jalmx/Smart-Switch/README.md

# Smart-Switch

Sistema inteligente para control de encendido de luces en interiores por medio de un switch touch o con un sensor PIR. Desarrollado con un PIC12F508

Información detalla del desarrollo esta en [documentación](documentacion/Smart_Switch.pdf)

# Vistas

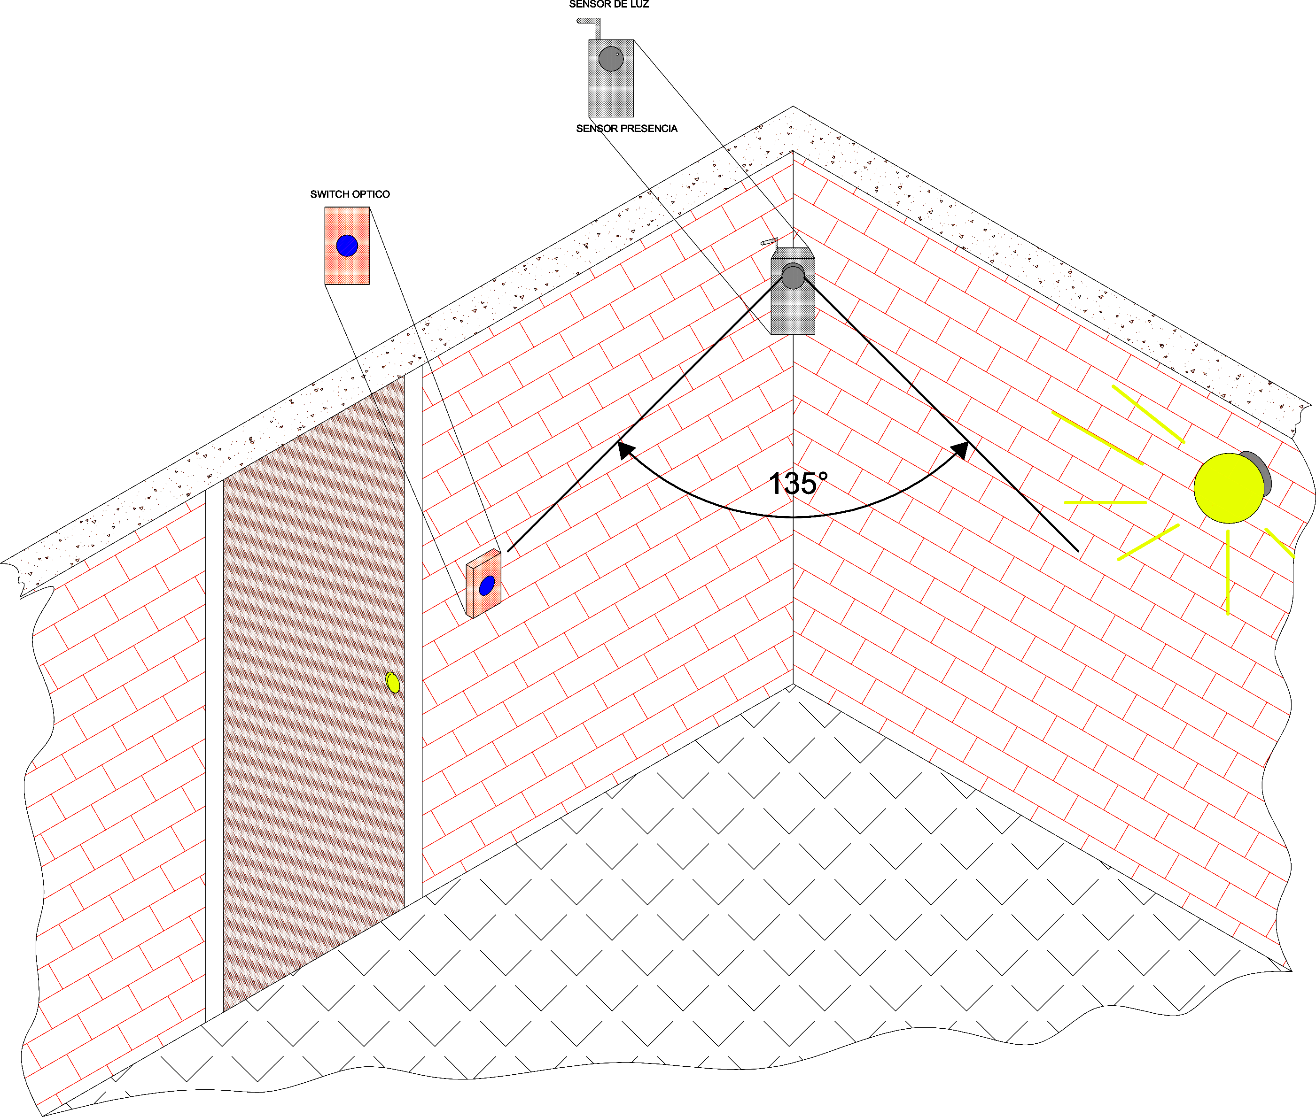
[picture p1: Gabinete y Pictorico/pictorico.png]
Pictorico
* 
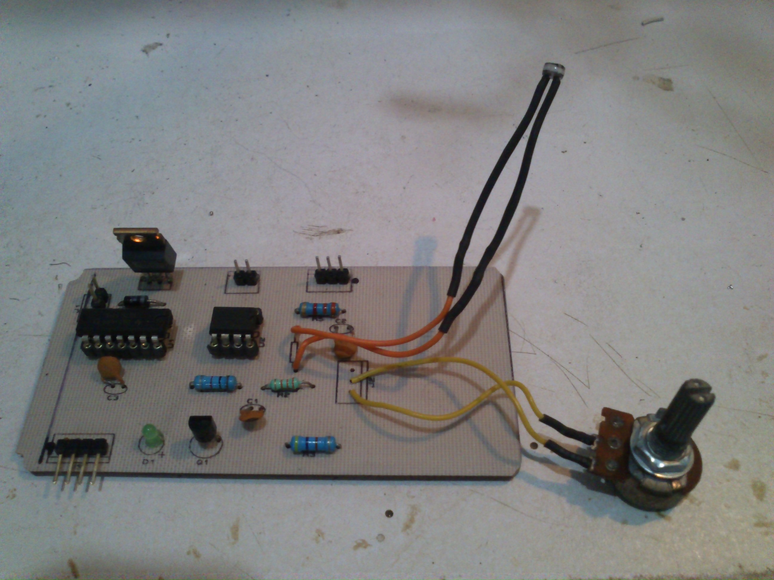
[picture p2: Fotos/2014-06-17 13.12.39.jpg]
Ultima vista
* 

## Esquematico

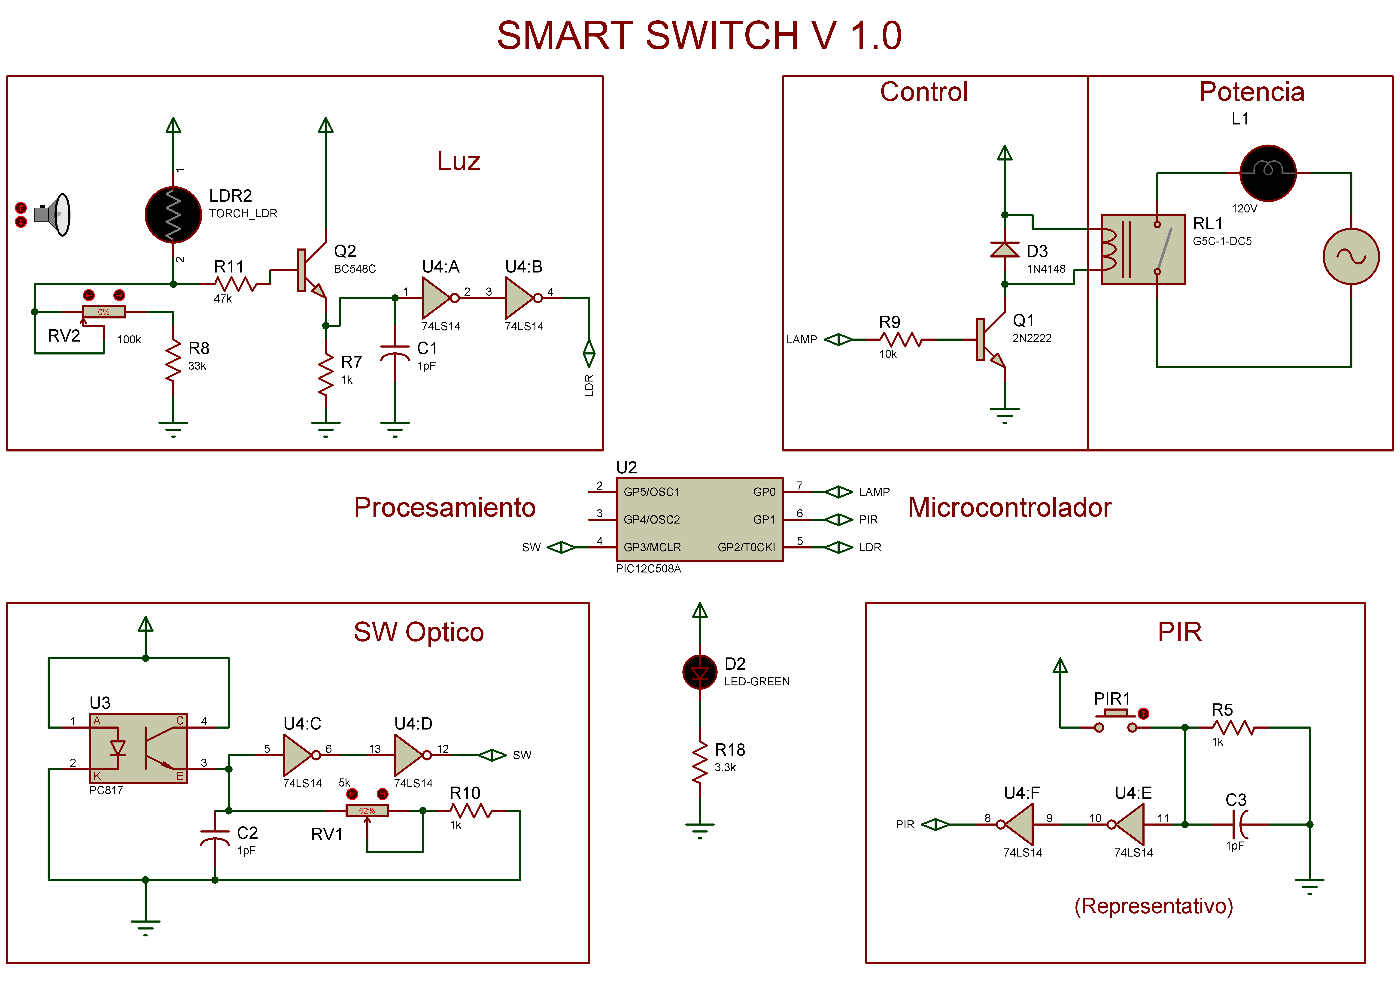
[picture p3: General/SW-SMART.png]
esquematico


# IDE de desarrollo:

* [Microchip X IDE](http://www.microchip.com/mplab/mplab-x-ide#) 

mplab x

* [Proteus](https://www.labcenter.com/)

proteus
