jalmx/Smart-Switch/PCB/SUB_PCB/SUB -3D Visualizer.pdf

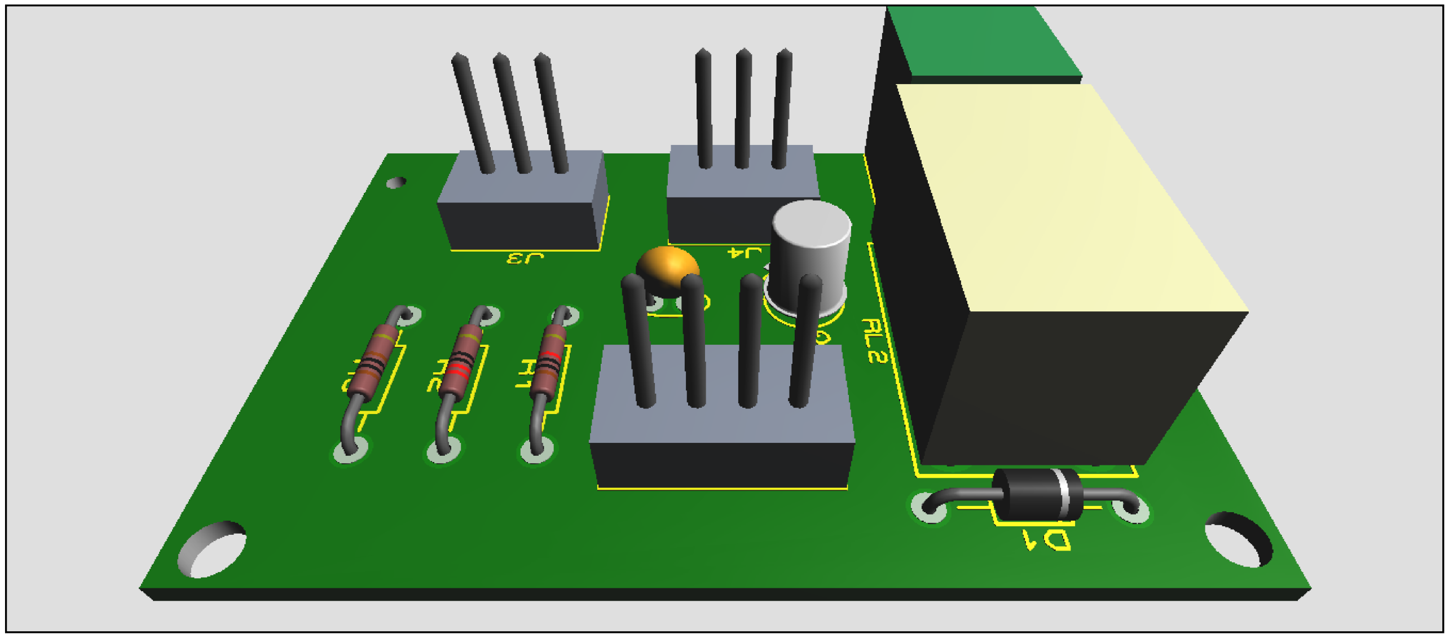
[picture p42: figure]
