jalmx/Smart-Switch/PCB/SW_OP_PCB/sw_op - Proteus 8 Professional - 3D Visualizer.pdf

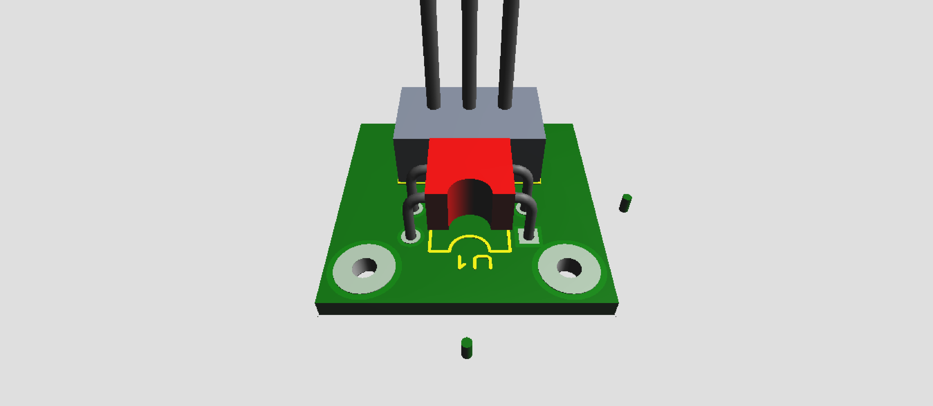
[picture p43: figure]
