jalmx/Smart-Switch/Fotos/2014-03-11 21.48.35.jpg

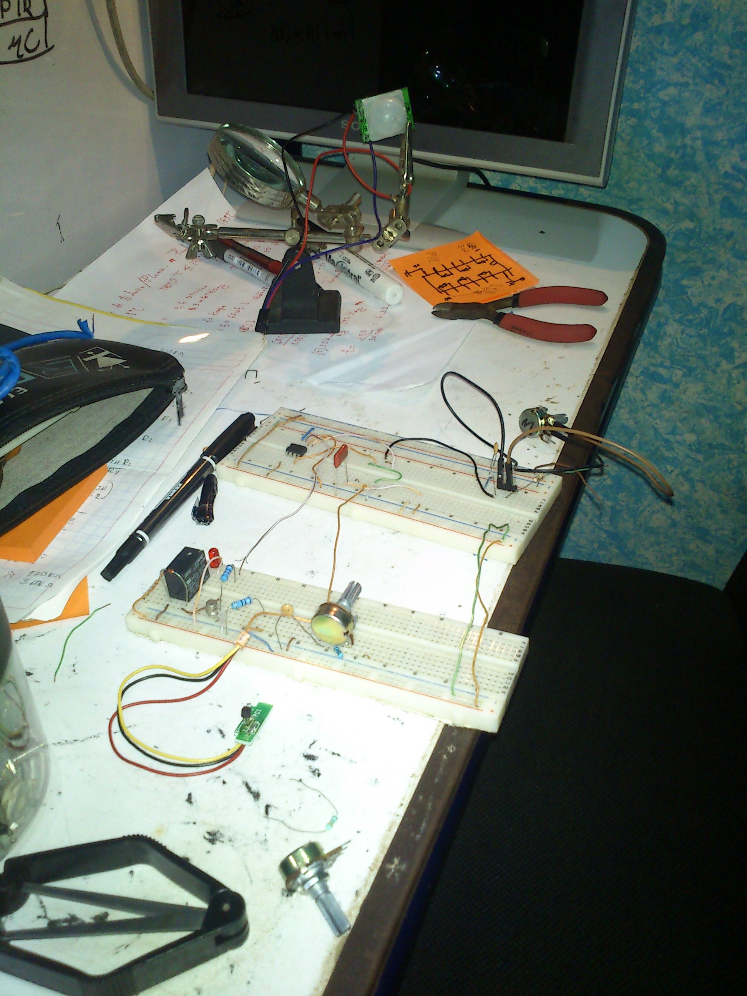
Fotos/2014-03-11 21.48.35.jpg
