jalmx/Smart-Switch/Fotos/2014-03-12 23.23.10.jpg

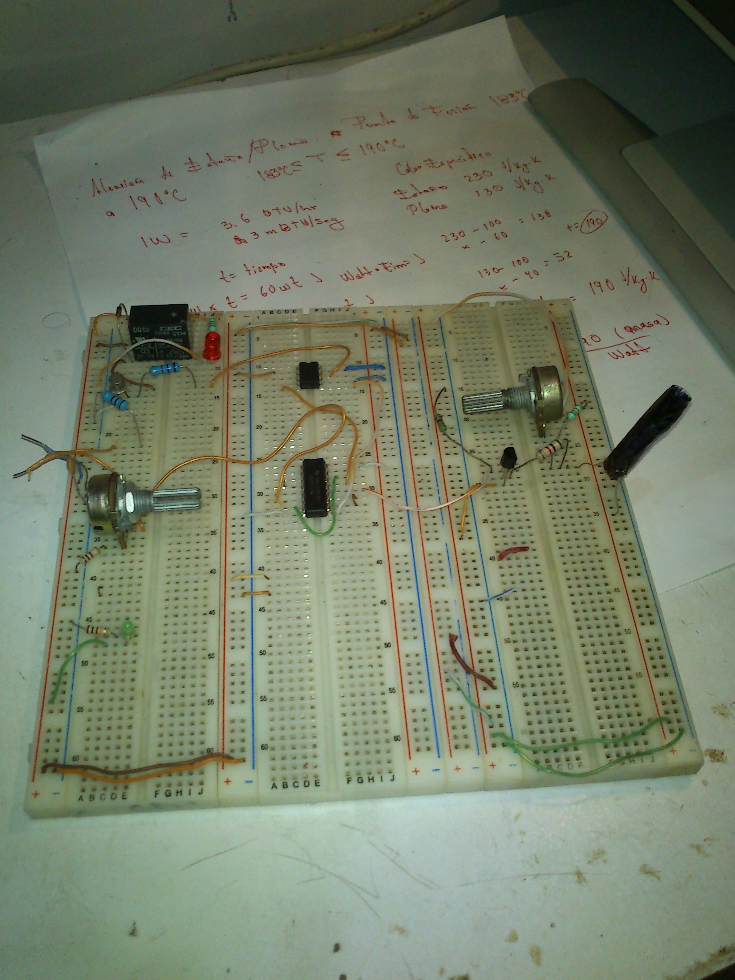
Fotos/2014-03-12 23.23.10.jpg
