jalmx/Smart-Switch/Fotos/2014-03-12 23.23.17.jpg

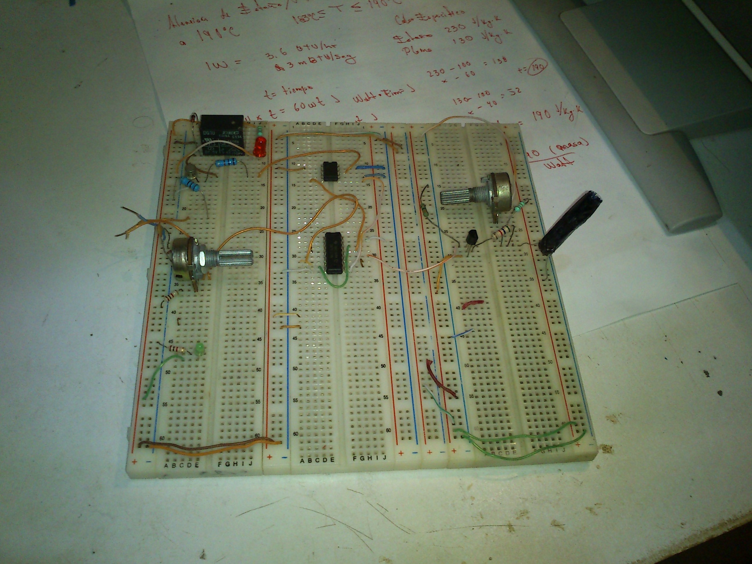
Fotos/2014-03-12 23.23.17.jpg
