jalmx/Smart-Switch/Fotos/2014-03-13 12.28.27.jpg

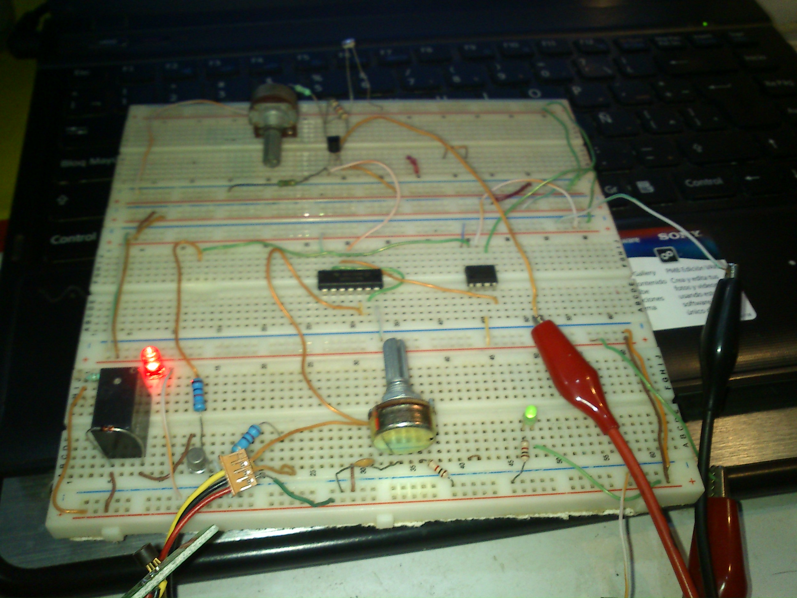
Fotos/2014-03-13 12.28.27.jpg
