jalmx/Smart-Switch/Fotos/2014-03-15 14.15.27.jpg

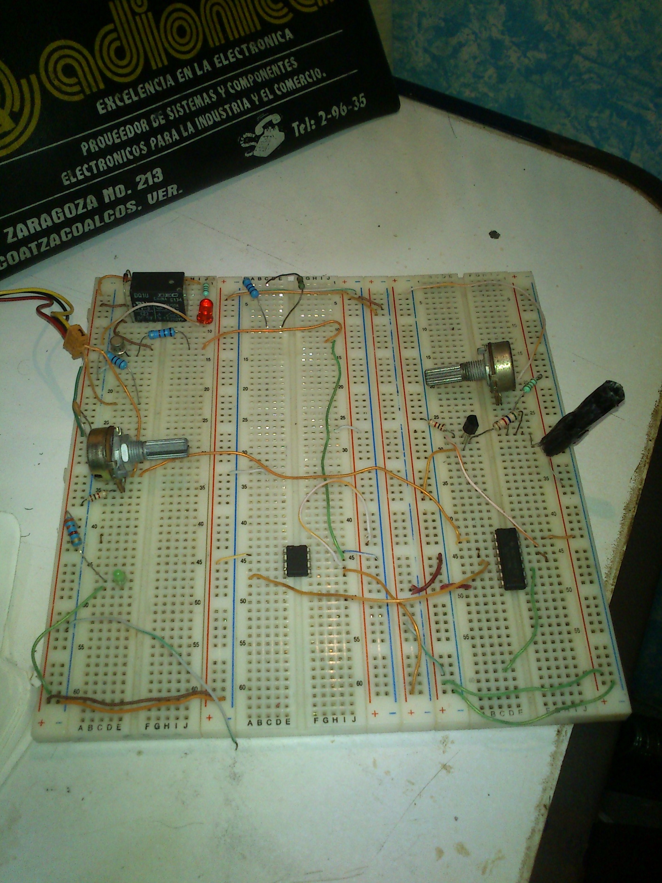
Fotos/2014-03-15 14.15.27.jpg
