jalmx/Smart-Switch/Fotos/2014-05-26 22.24.50.jpg

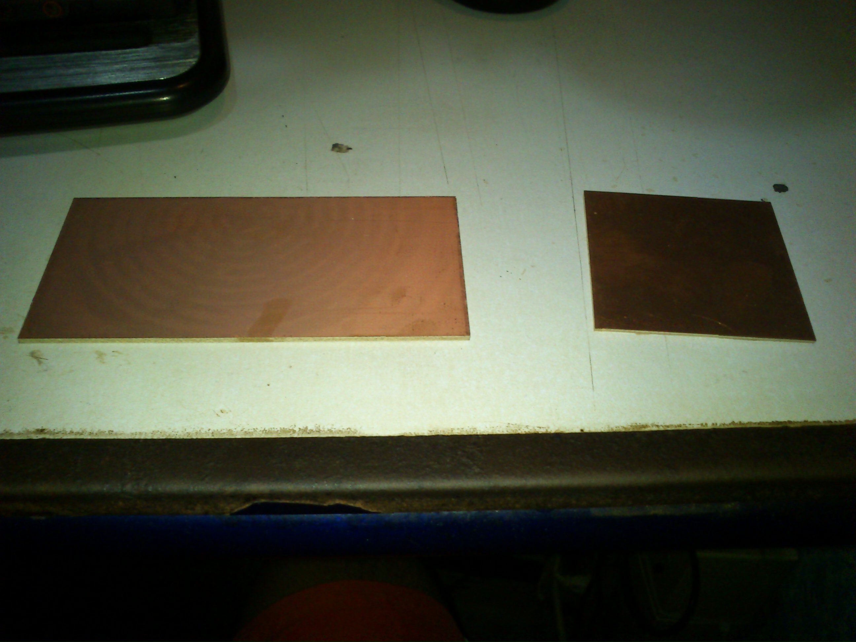
Fotos/2014-05-26 22.24.50.jpg
