jalmx/Smart-Switch/Fotos/2014-05-27 14.17.57.jpg

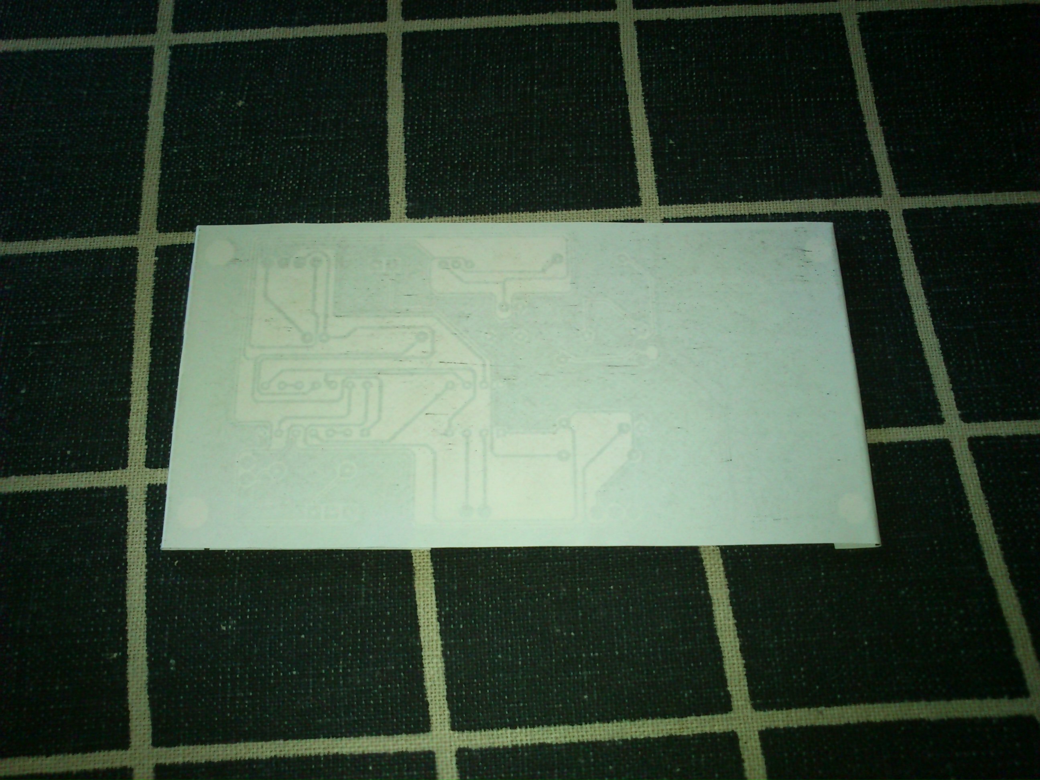
Fotos/2014-05-27 14.17.57.jpg
