jalmx/Smart-Switch/Fotos/2014-05-27 14.18.19.jpg

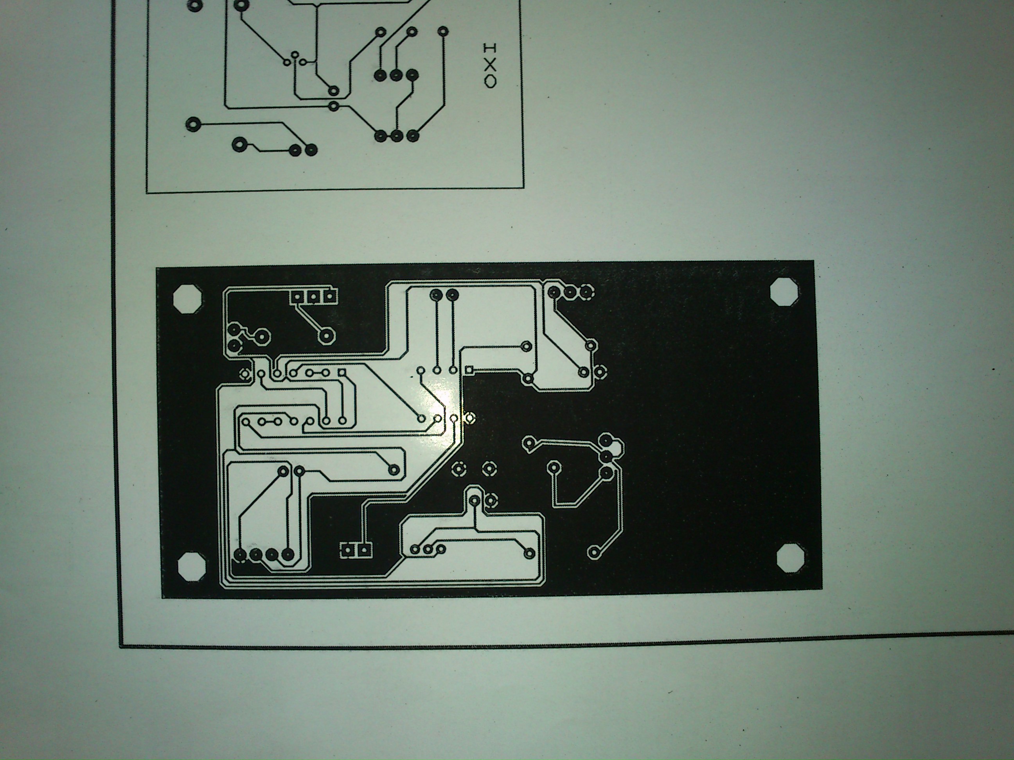
Fotos/2014-05-27 14.18.19.jpg
