jalmx/Smart-Switch/Fotos/2014-05-27 14.36.23.jpg

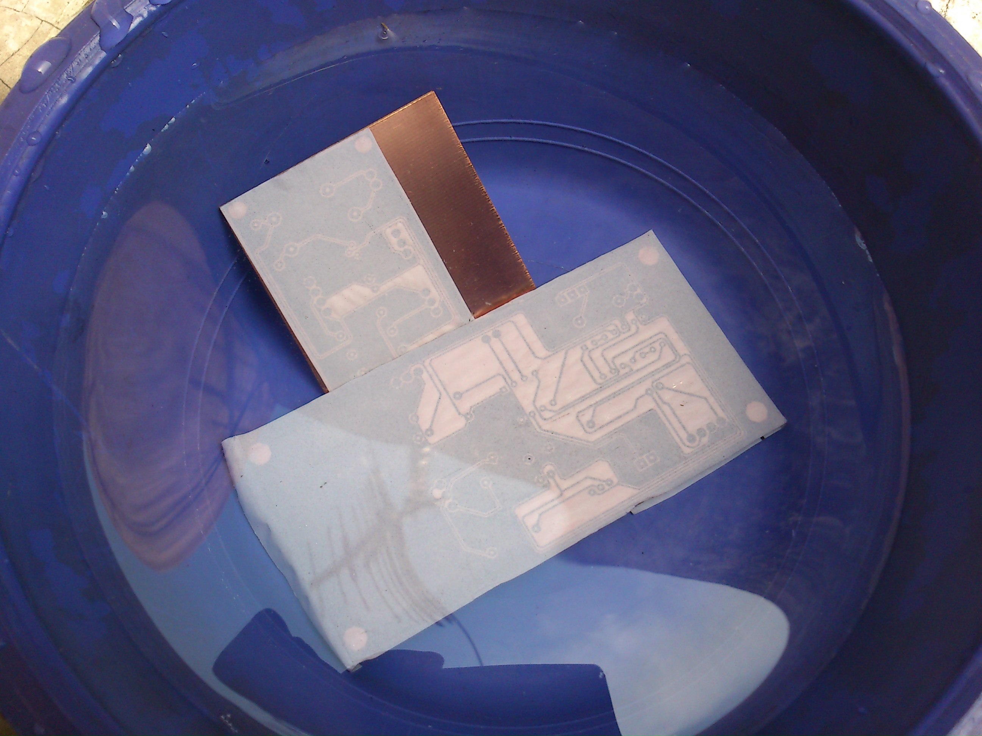
Fotos/2014-05-27 14.36.23.jpg
