jalmx/Smart-Switch/Fotos/2014-06-09 14.02.02.jpg

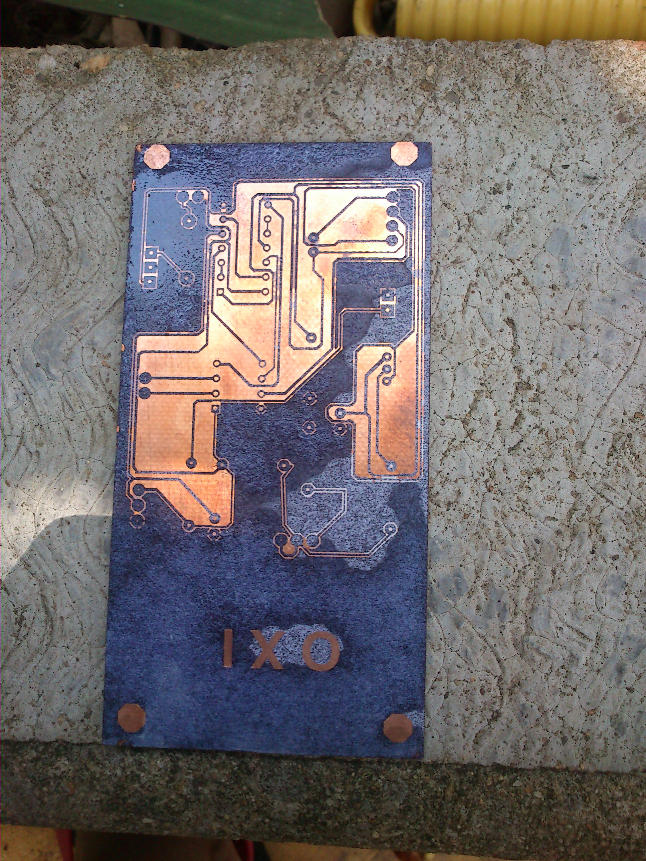
Fotos/2014-06-09 14.02.02.jpg
