jalmx/Smart-Switch/Fotos/2014-06-09 14.02.08.jpg

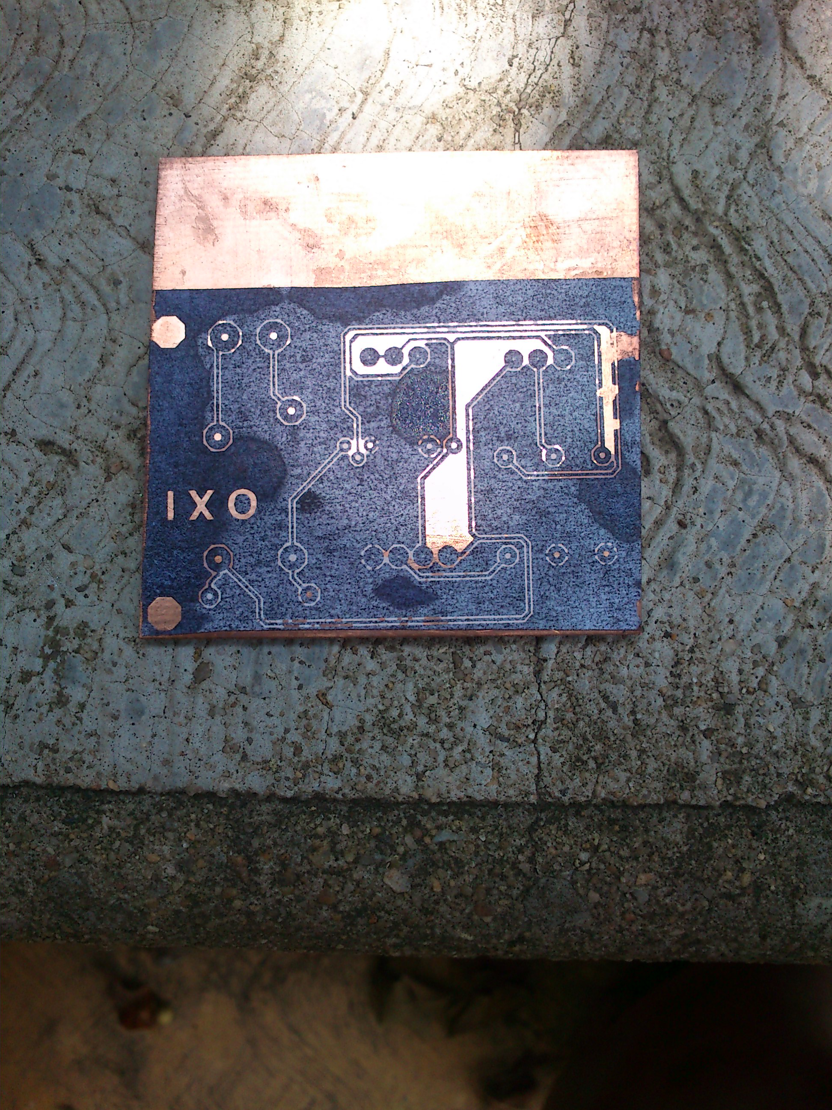
Fotos/2014-06-09 14.02.08.jpg
