jalmx/Smart-Switch/Fotos/2014-06-09 14.03.07.jpg

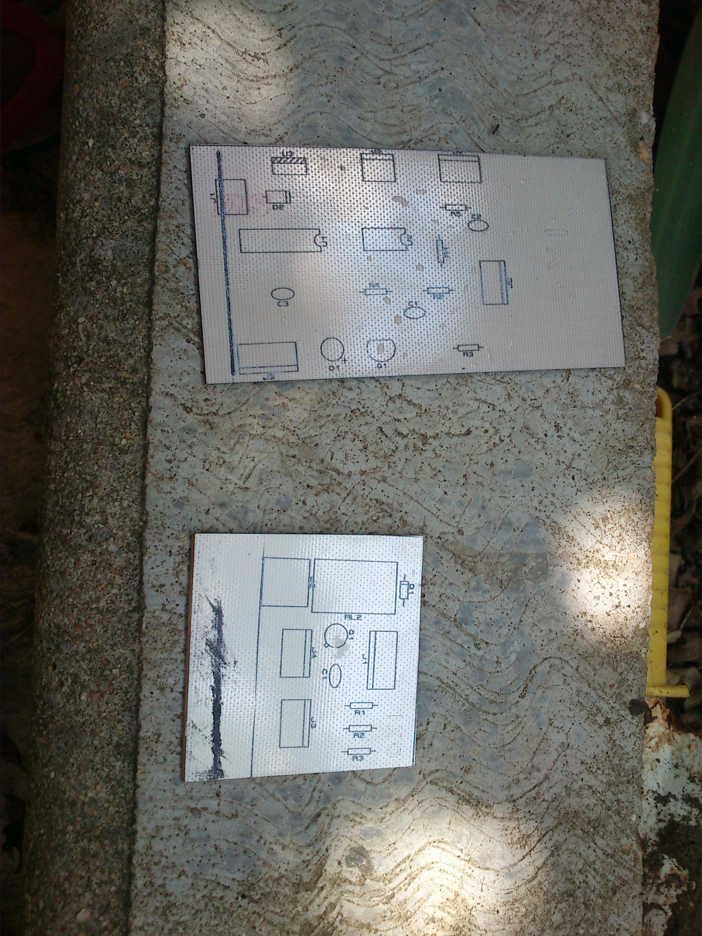
Fotos/2014-06-09 14.03.07.jpg
