jalmx/Smart-Switch/Fotos/2014-06-09 14.08.54.jpg

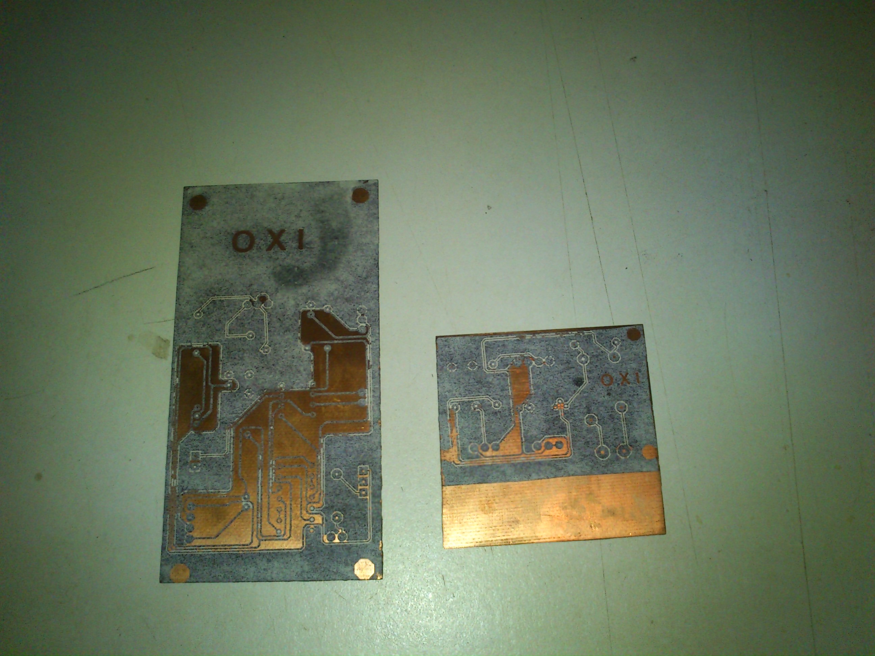
Fotos/2014-06-09 14.08.54.jpg
