jalmx/Smart-Switch/Fotos/2014-06-09 14.09.16.jpg

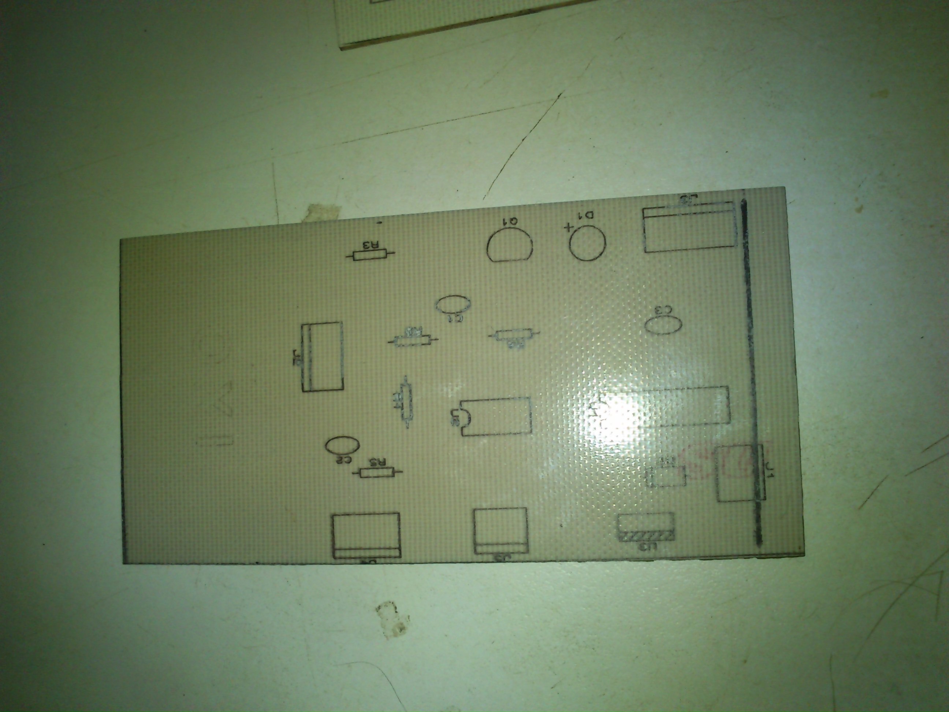
Fotos/2014-06-09 14.09.16.jpg
