jalmx/Smart-Switch/Fotos/2014-06-09 14.09.24.jpg

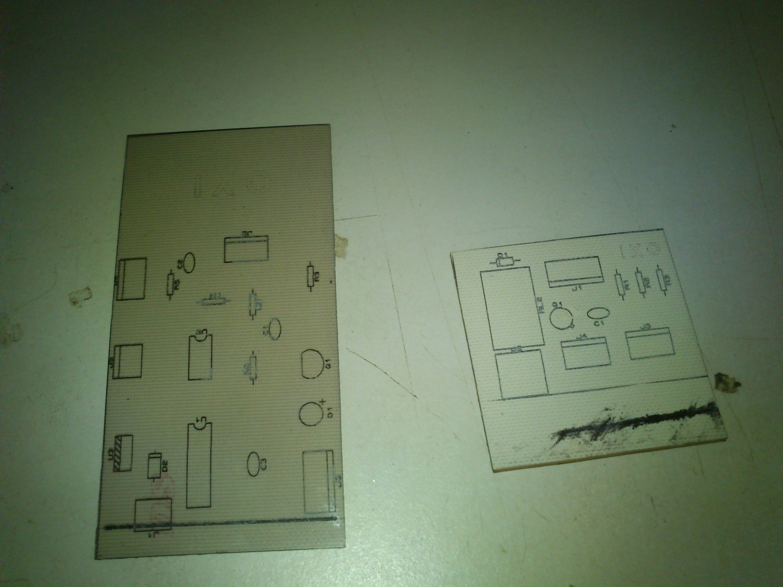
Fotos/2014-06-09 14.09.24.jpg
