jalmx/Smart-Switch/Fotos/2014-06-09 15.44.30.jpg

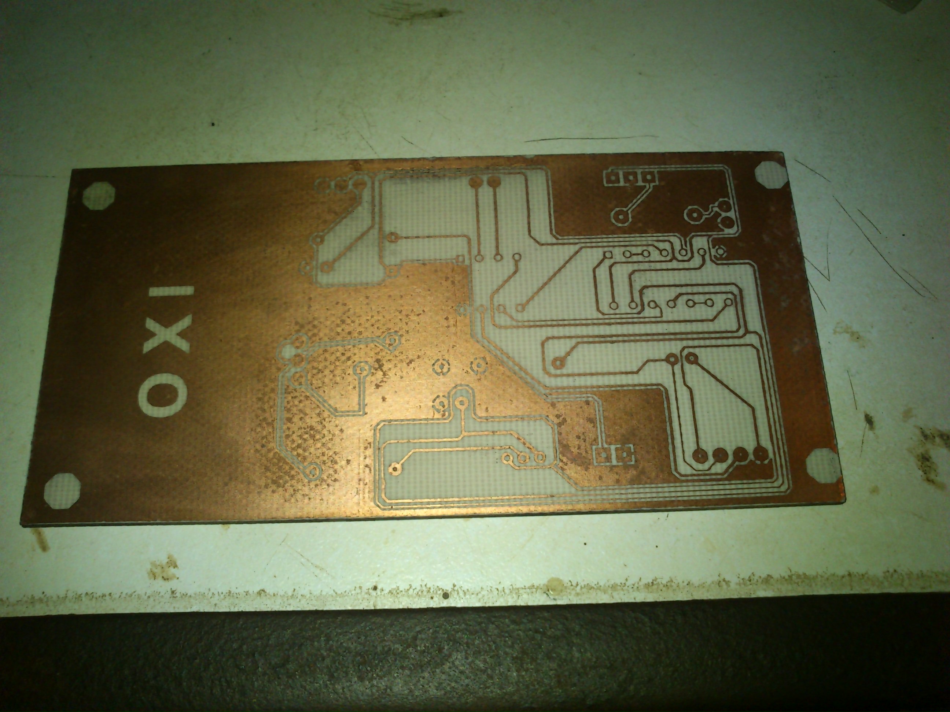
Fotos/2014-06-09 15.44.30.jpg
