jalmx/Smart-Switch/Fotos/2014-06-09 15.44.52.jpg

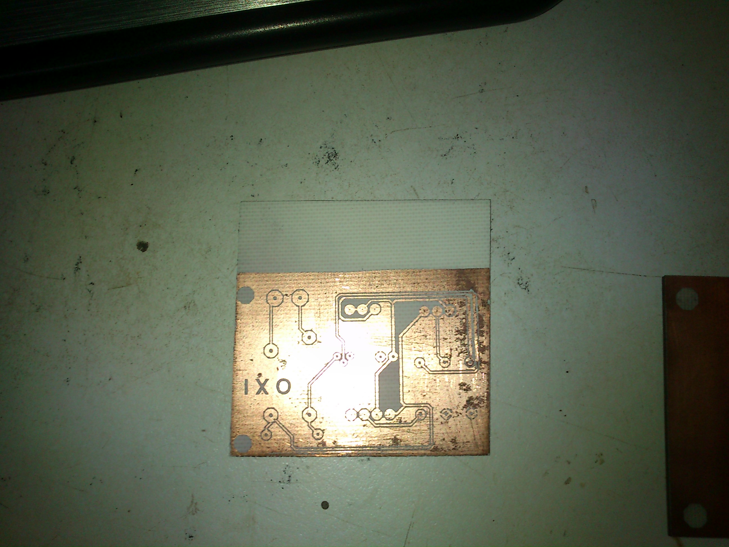
Fotos/2014-06-09 15.44.52.jpg
