jalmx/Smart-Switch/Fotos/2014-06-09 15.45.00.jpg

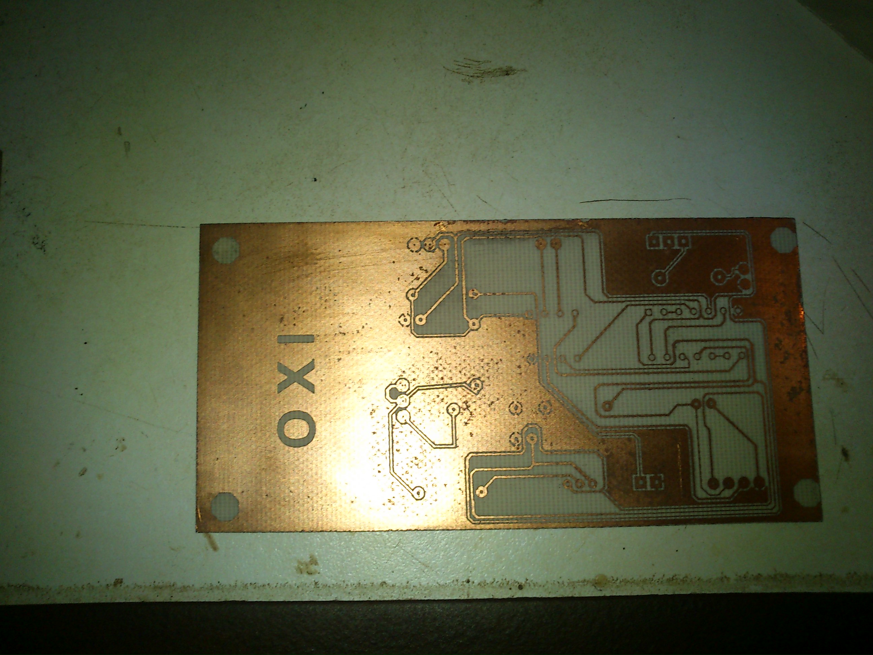
Fotos/2014-06-09 15.45.00.jpg
