jalmx/Smart-Switch/Fotos/2014-06-09 15.45.33.jpg

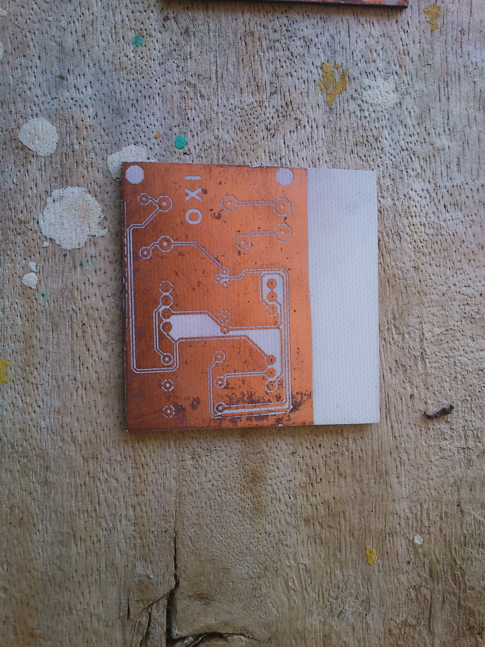
Fotos/2014-06-09 15.45.33.jpg
