jalmx/Smart-Switch/Fotos/2014-06-09 15.45.46.jpg

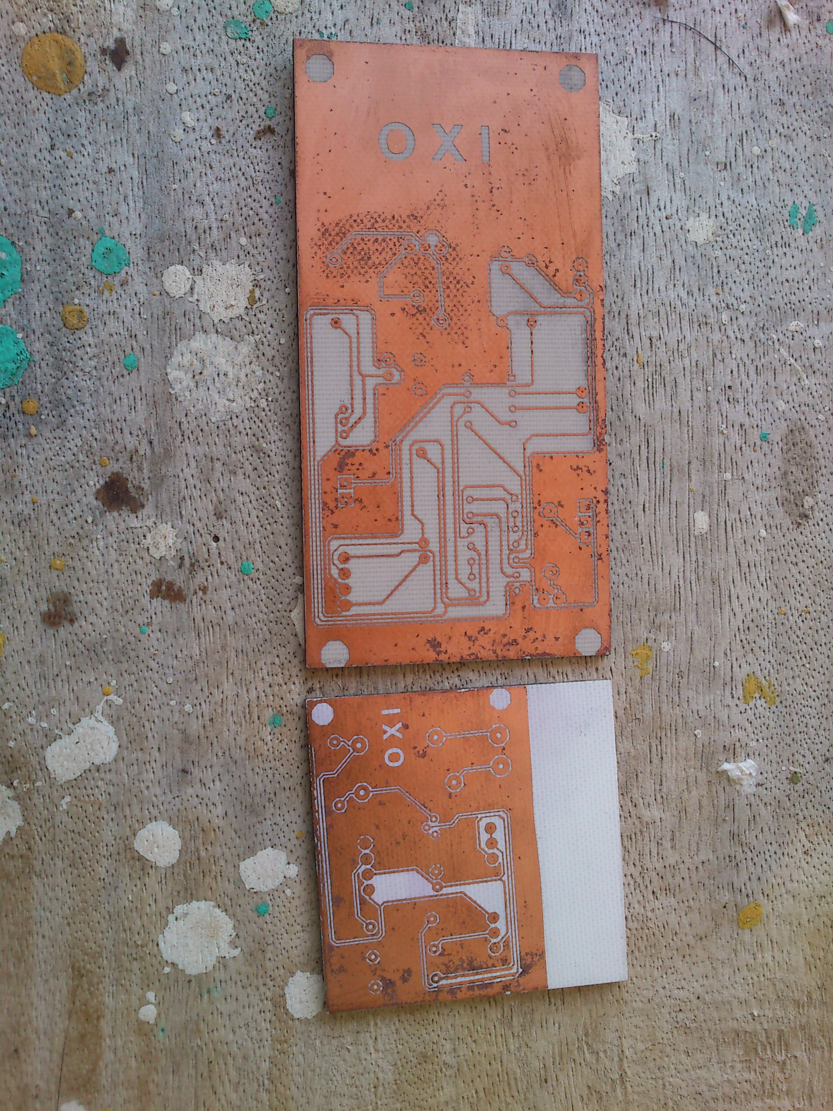
Fotos/2014-06-09 15.45.46.jpg
