jalmx/Smart-Switch/Fotos/2014-06-09 17.20.19.jpg

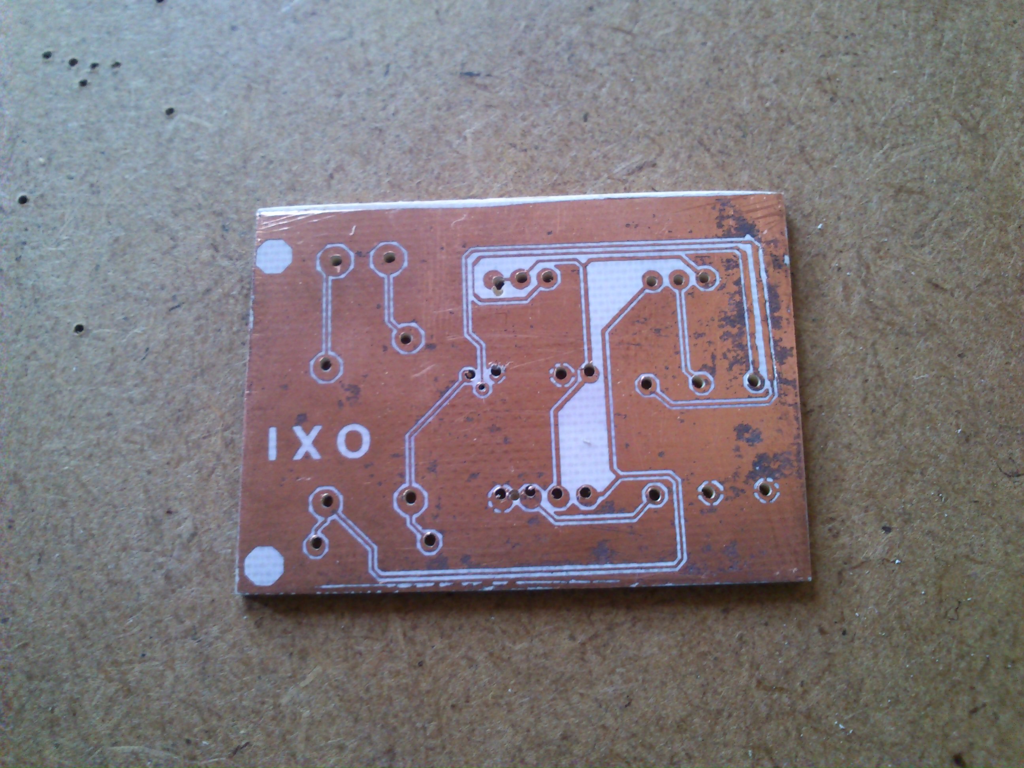
Fotos/2014-06-09 17.20.19.jpg
