jalmx/Smart-Switch/Fotos/2014-06-09 17.20.40.jpg

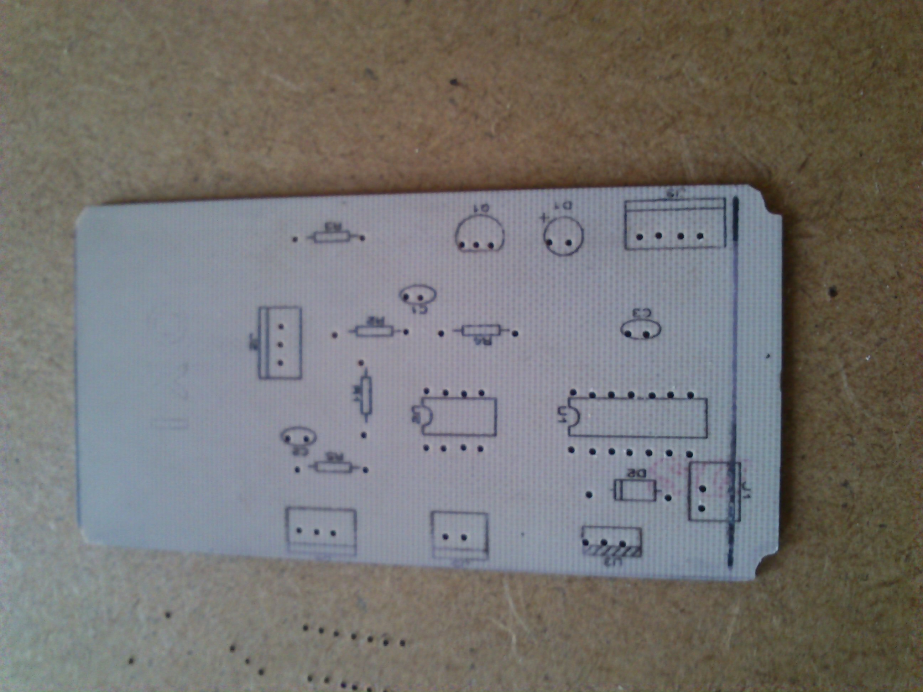
Fotos/2014-06-09 17.20.40.jpg
