jalmx/Smart-Switch/Fotos/2014-06-17 13.10.56.jpg

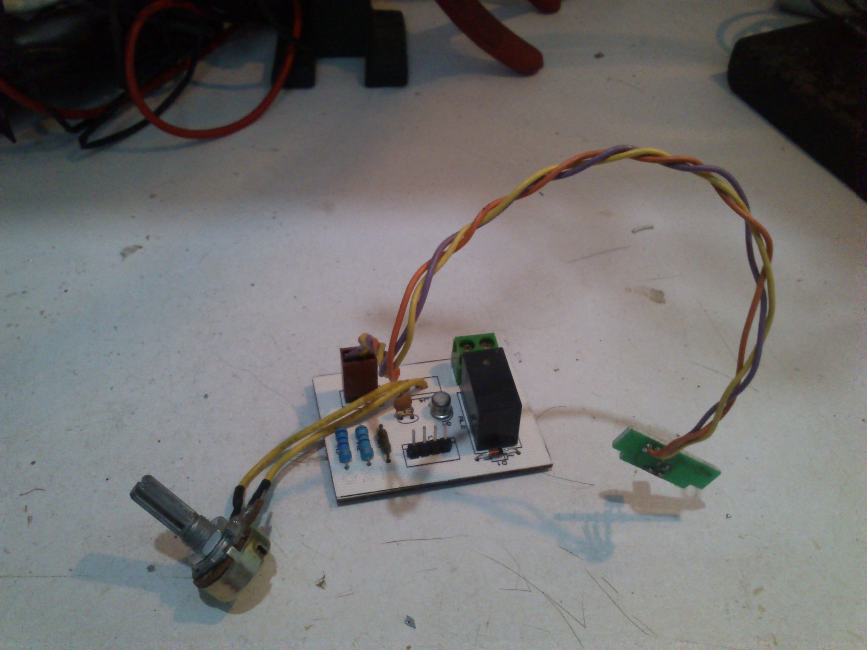
Fotos/2014-06-17 13.10.56.jpg
