jalmx/Smart-Switch/Fotos/2014-06-17 13.11.48.jpg

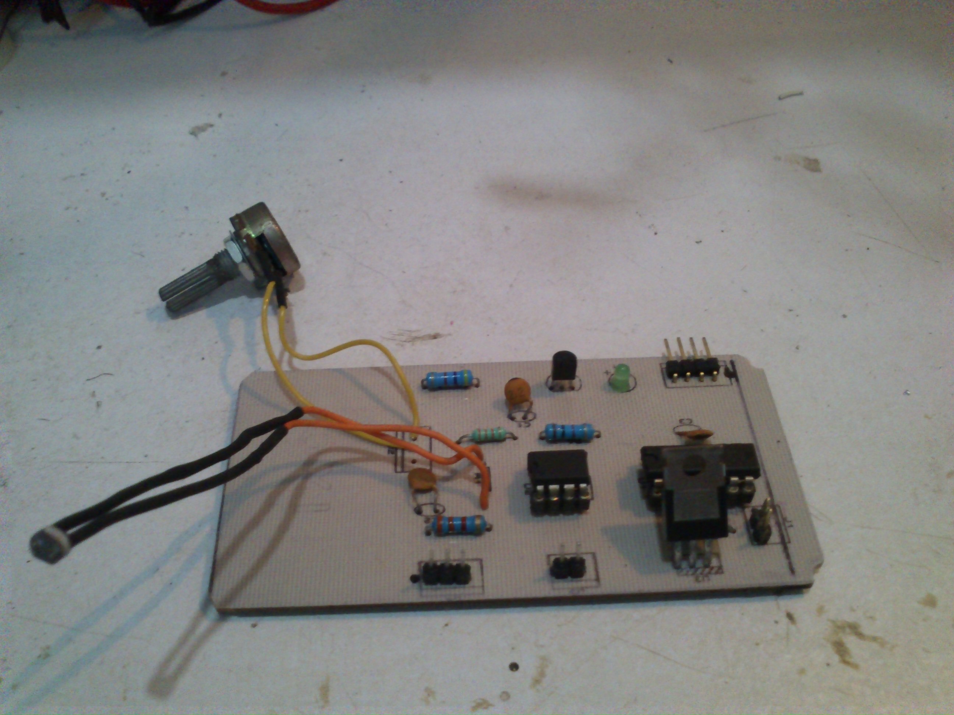
Fotos/2014-06-17 13.11.48.jpg
