jalmx/Smart-Switch/Fotos/2014-06-17 13.11.54.jpg

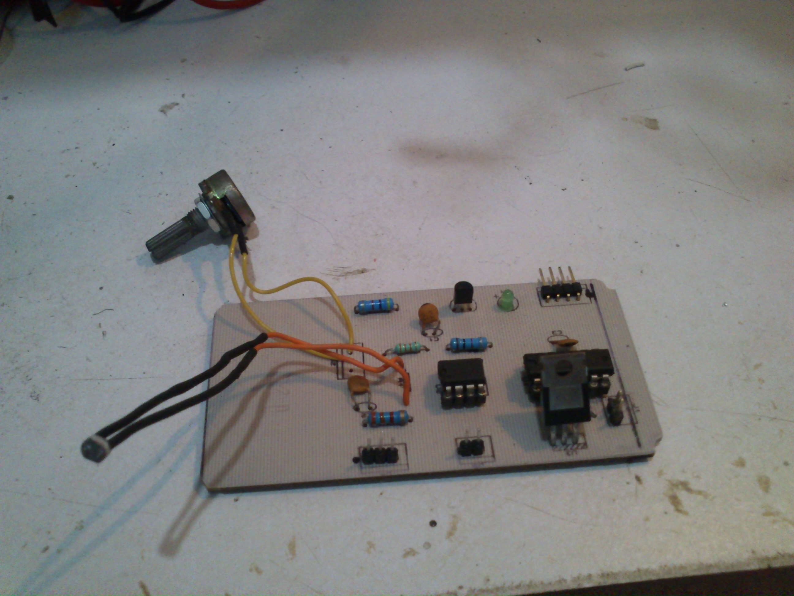
Fotos/2014-06-17 13.11.54.jpg
