jalmx/Smart-Switch/Fotos/2014-06-17 13.12.06.jpg

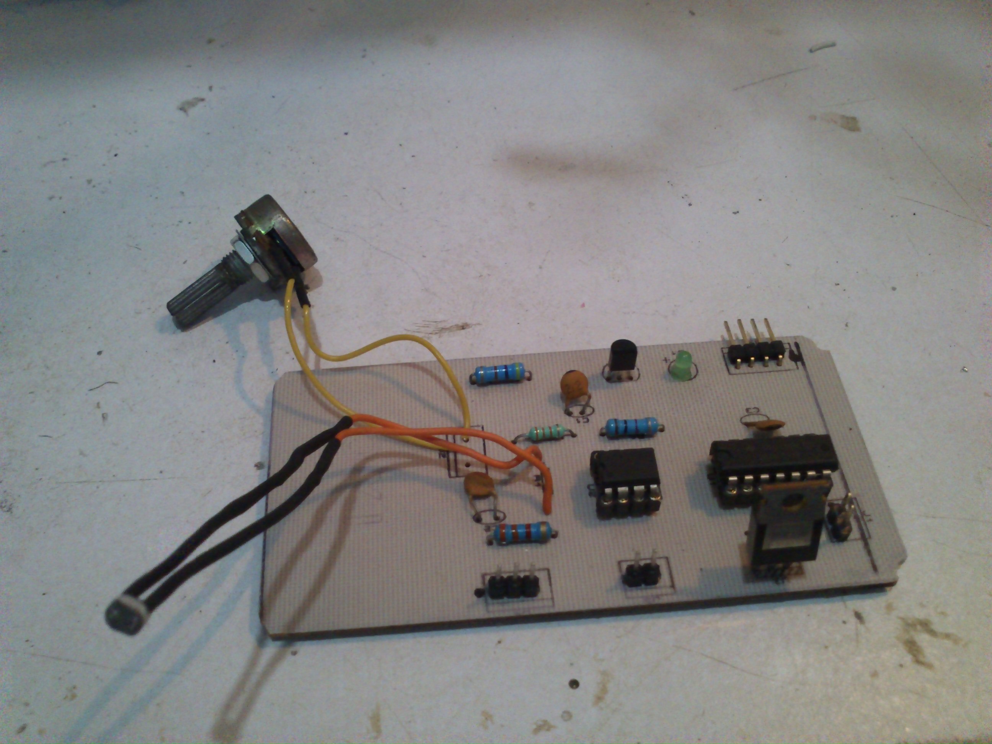
Fotos/2014-06-17 13.12.06.jpg
