jalmx/Smart-Switch/Fotos/2014-06-30 10.55.46.jpg

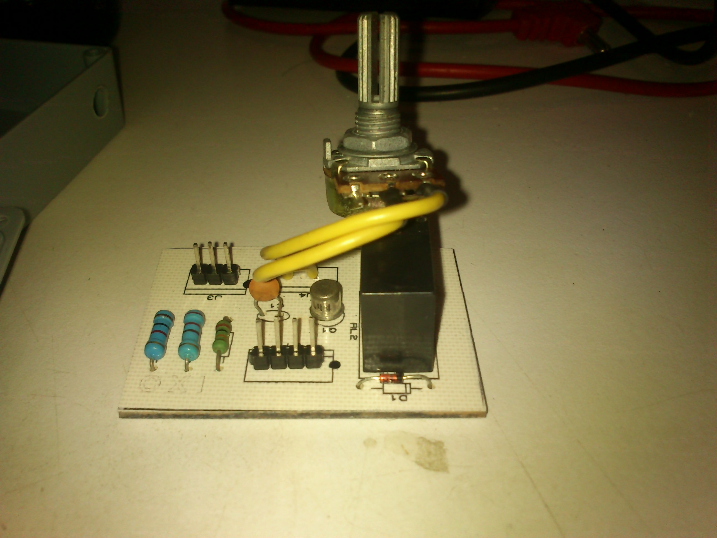
Fotos/2014-06-30 10.55.46.jpg
