jalmx/Smart-Switch/Fotos/2014-06-30 10.56.12.jpg

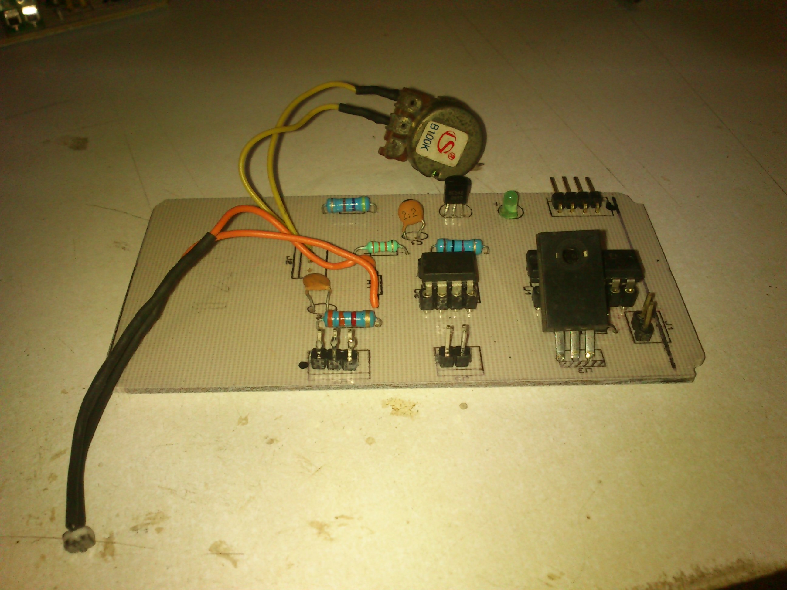
Fotos/2014-06-30 10.56.12.jpg
