jalmx/Smart-Switch/Fotos/2014-06-30 12.27.43.jpg

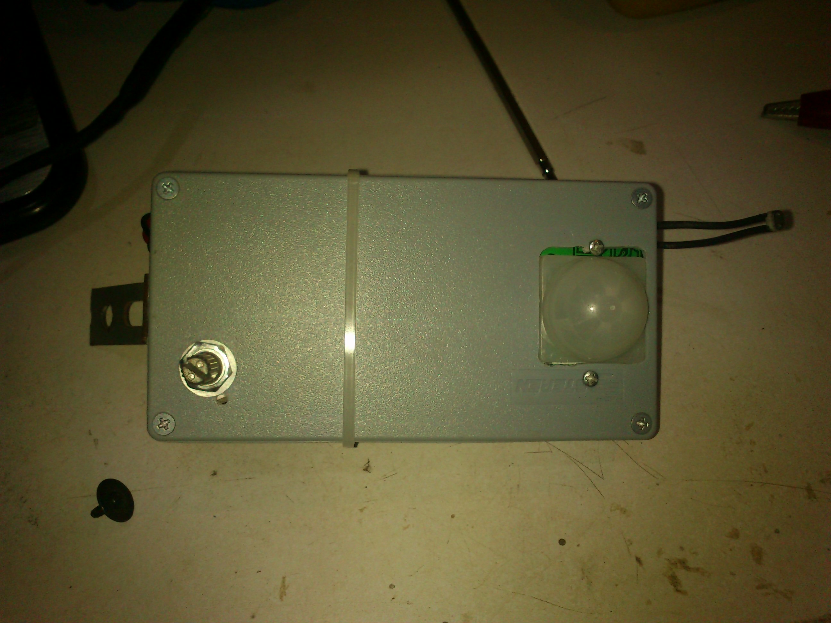
Fotos/2014-06-30 12.27.43.jpg
