jalmx/Smart-Switch/Fotos/2014-06-30 12.27.58.jpg

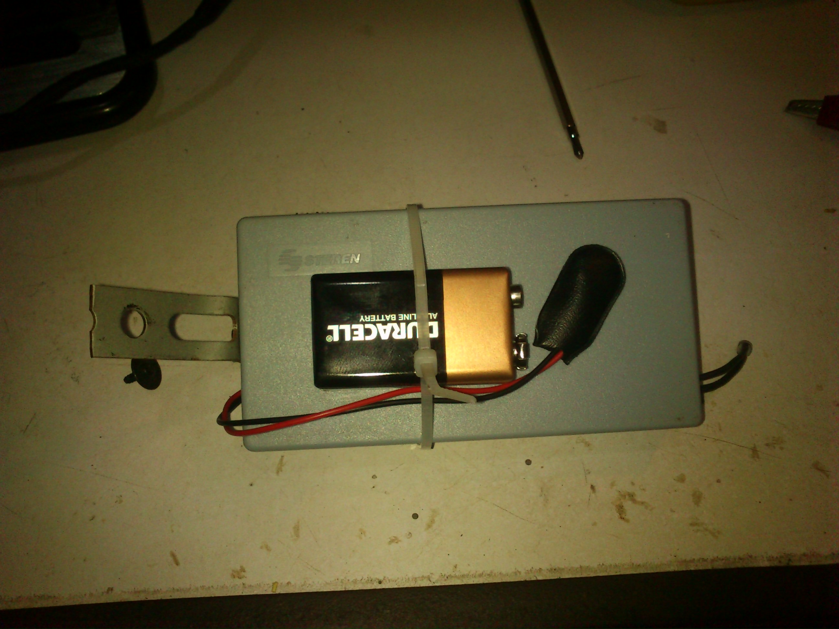
Fotos/2014-06-30 12.27.58.jpg
