jalmx/Smart-Switch/Fotos/2014-06-30 12.28.06.jpg

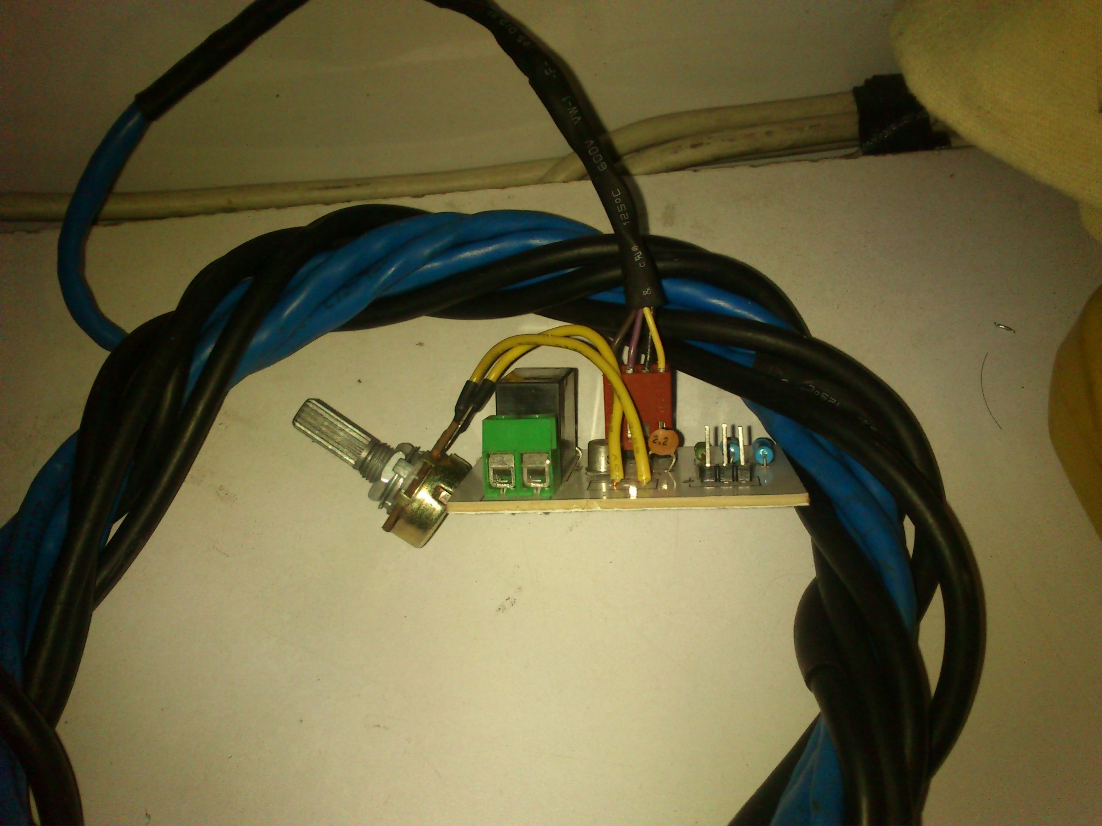
Fotos/2014-06-30 12.28.06.jpg
