jalmx/Smart-Switch/Fotos/2014-06-30 12.34.28.jpg

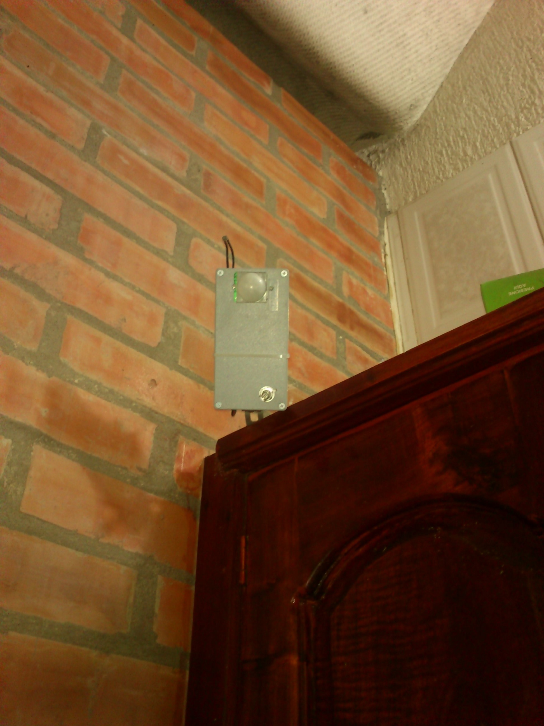
Fotos/2014-06-30 12.34.28.jpg
