jalmx/Smart-Switch/Fotos/2014-06-30 12.34.35.jpg

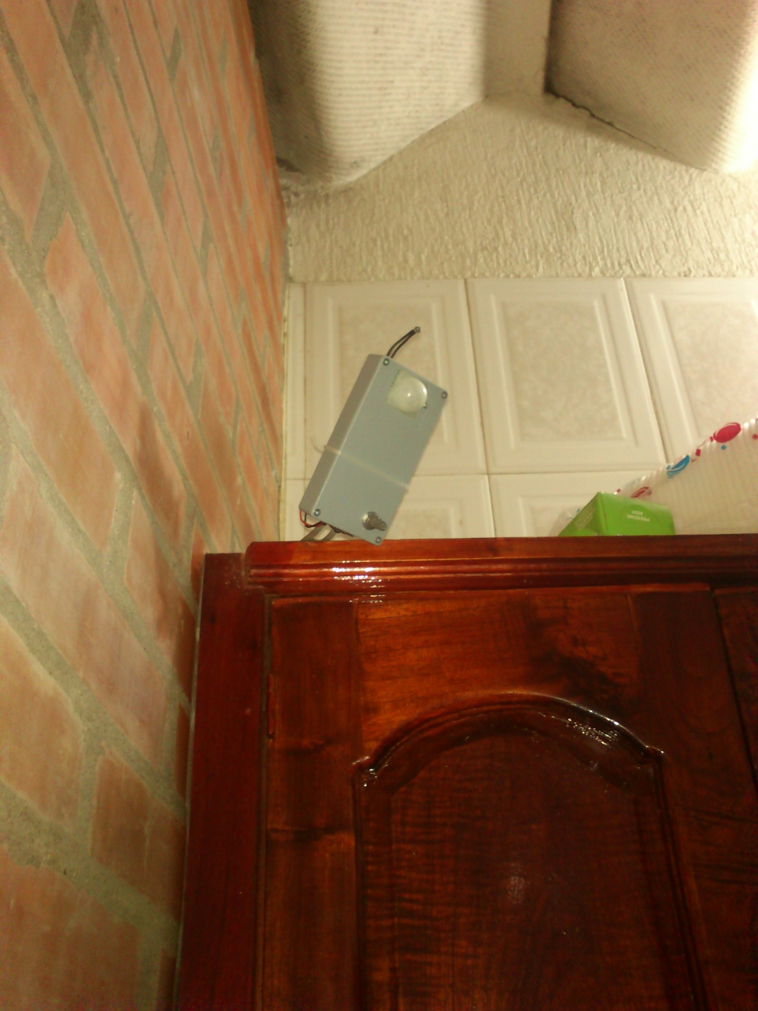
Fotos/2014-06-30 12.34.35.jpg
