jalmx/Smart-Switch/Fotos/2014-06-30 13.16.07.jpg

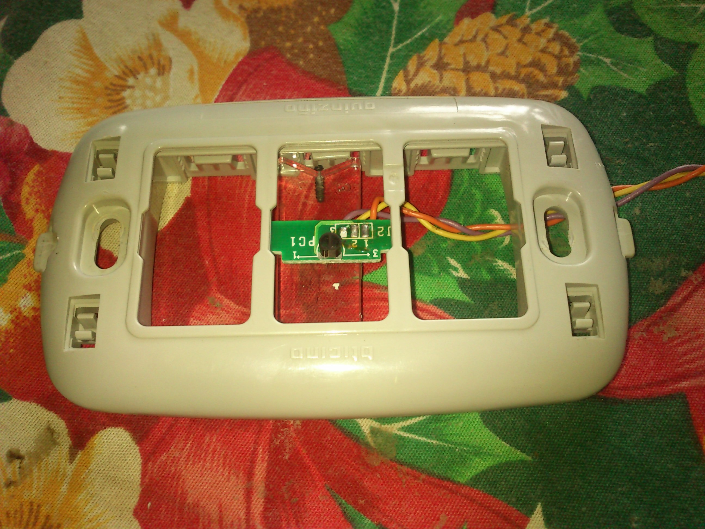
Fotos/2014-06-30 13.16.07.jpg
