jalmx/Smart-Switch/Fotos/2014-06-30 13.16.16.jpg

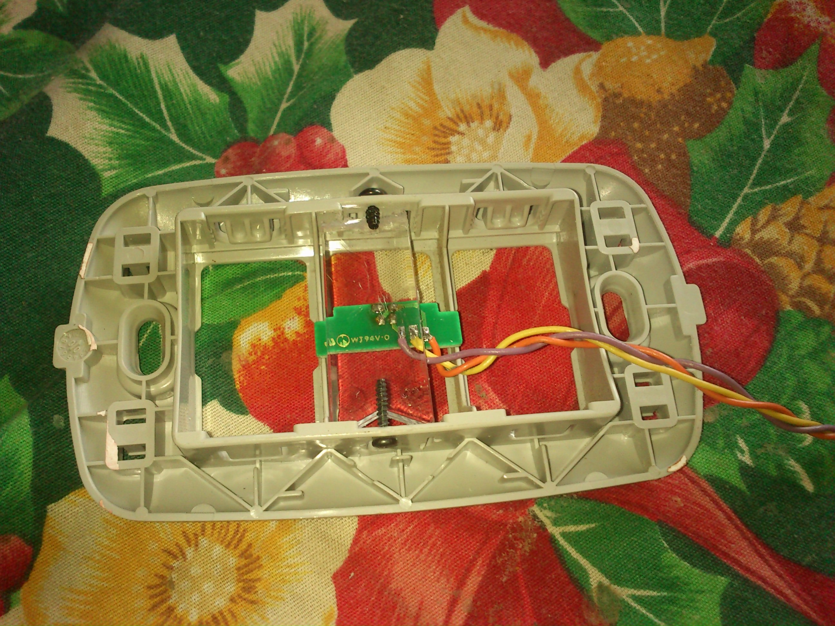
Fotos/2014-06-30 13.16.16.jpg
