jalmx/Smart-Switch/Fotos/2014-06-30 13.16.41.jpg

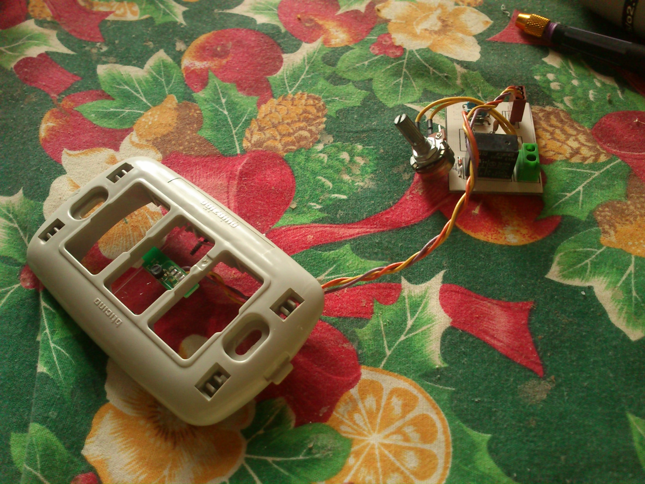
Fotos/2014-06-30 13.16.41.jpg
