jalmx/Smart-Switch/Fotos/2014-06-30 14.22.27.jpg

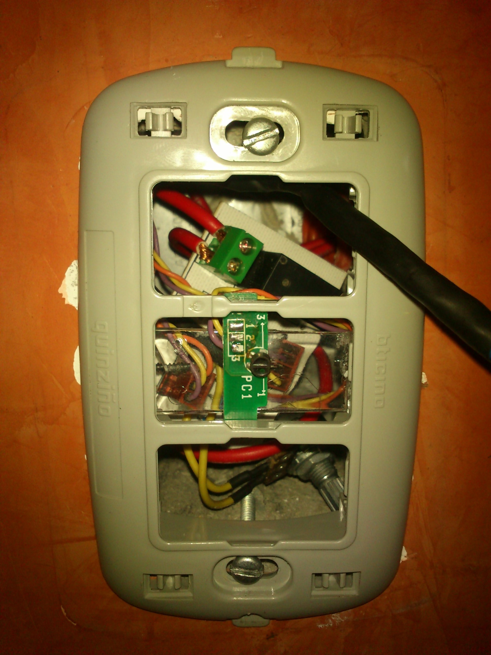
Fotos/2014-06-30 14.22.27.jpg
