jalmx/Smart-Switch/Fotos/2014-06-30 14.22.35.jpg

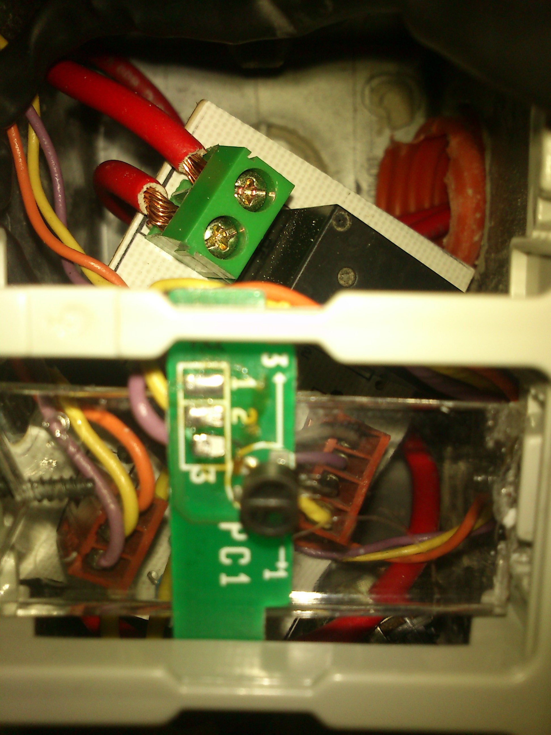
Fotos/2014-06-30 14.22.35.jpg
