jalmx/Smart-Switch/Fotos/2014-07-13 20.07.41.jpg

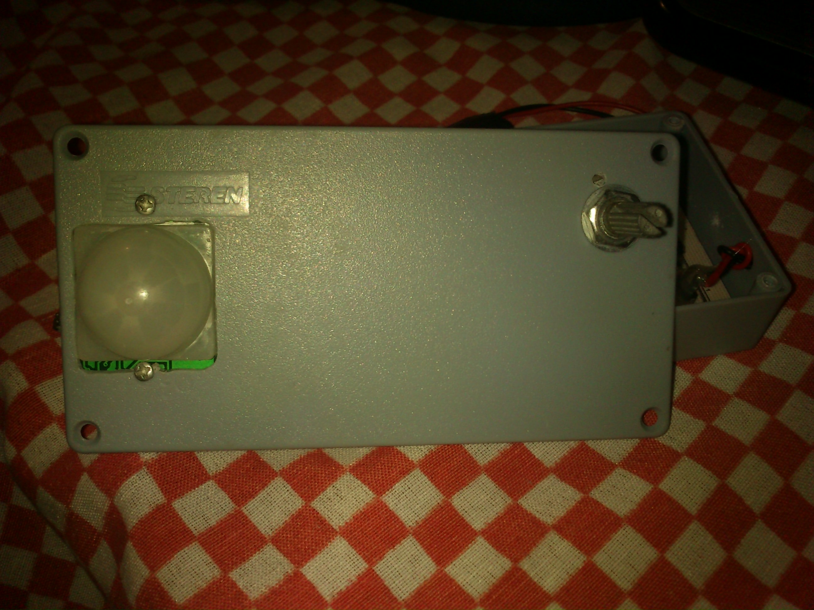
Fotos/2014-07-13 20.07.41.jpg
