jalmx/Smart-Switch/PCB/SW_OP_PCB/sw_op.png

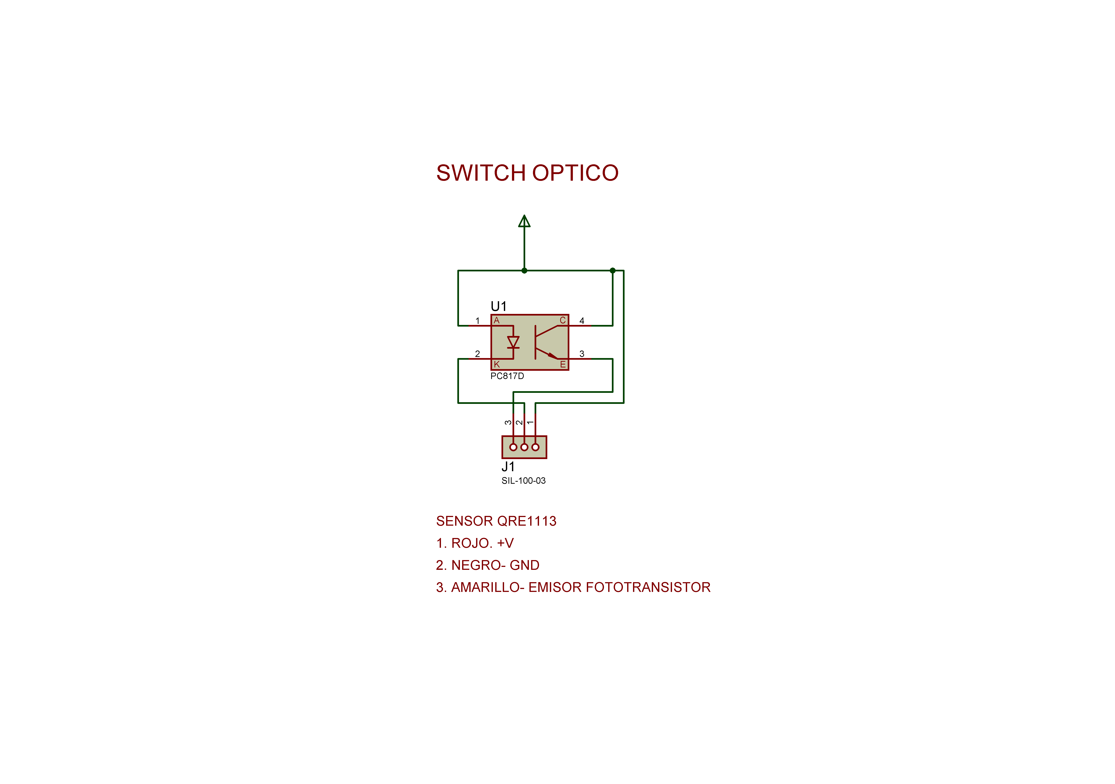
PCB/SW_OP_PCB/sw_op.png
