jalmx/Smart-Switch/PCB/SUB_PCB/SUB_componentes.pdf

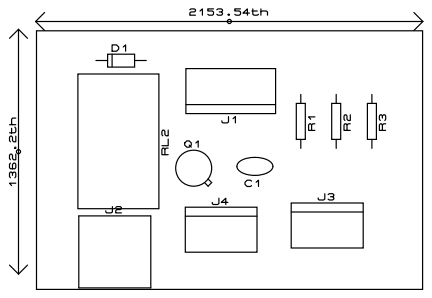
[picture p95: figure]
