jalmx/Smart-Switch/PCB/MAIN_PCB/MAINt - 3D Visualizer.pdf

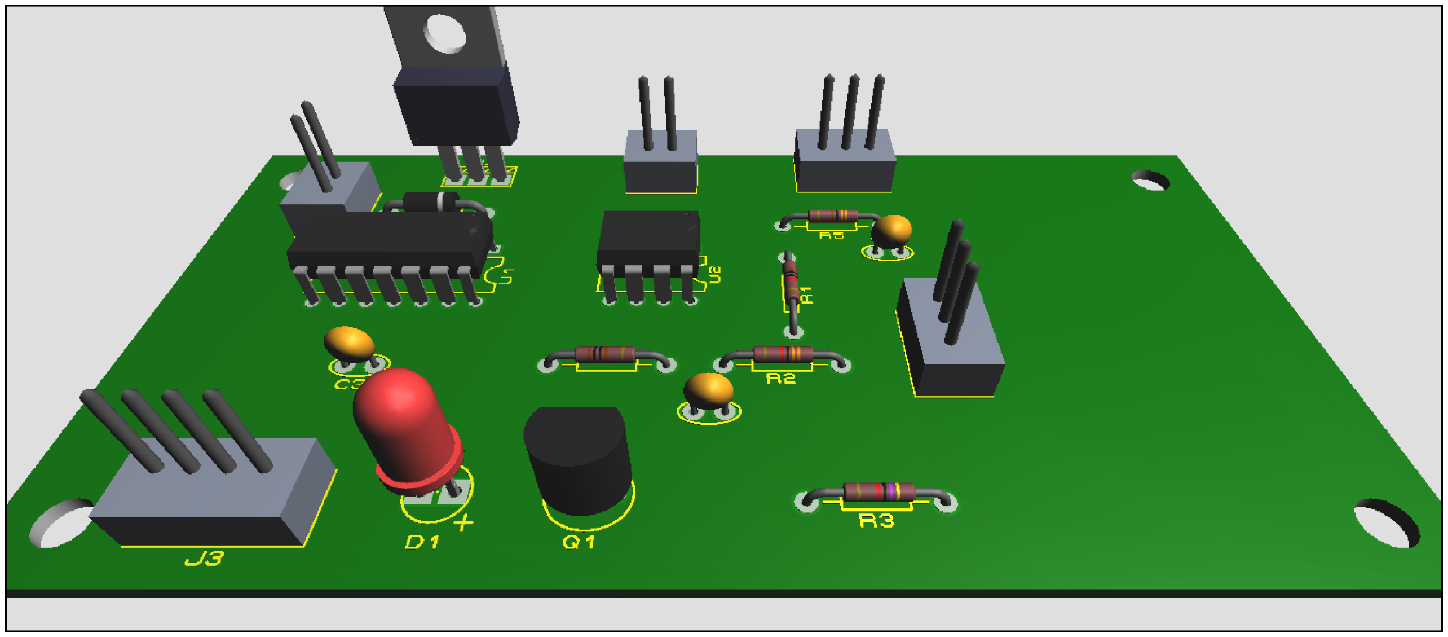
[picture p96: figure]
