jalmx/Smart-Switch/PCB/MAIN_PCB/MAINt.png

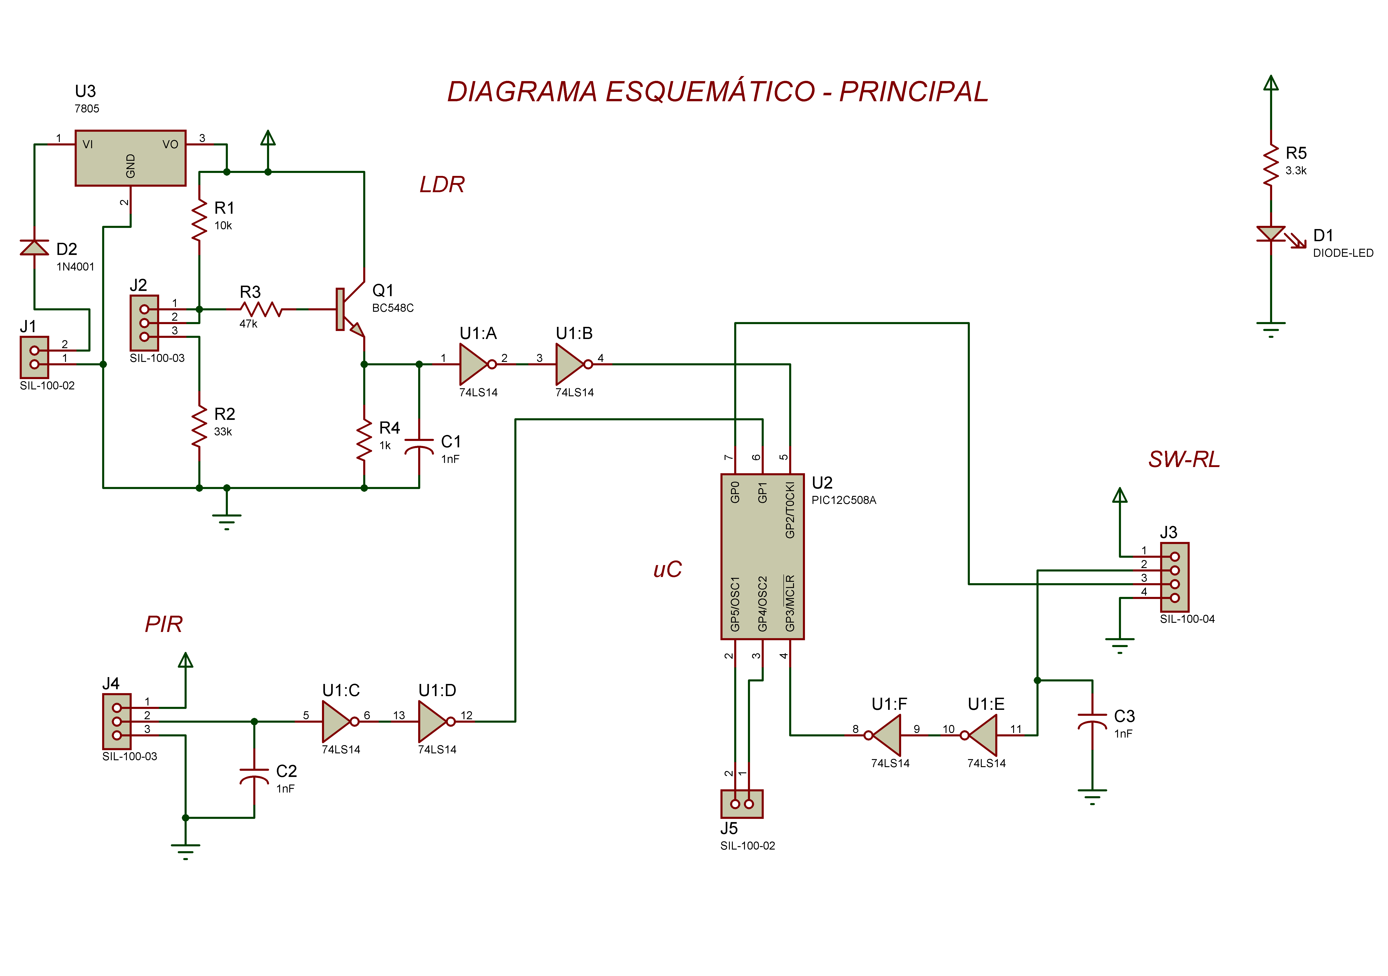
PCB/MAIN_PCB/MAINt.png
