jalmx/Smart-Switch/PCB/MAIN_PCB/MAINt.PDF

R1

U3

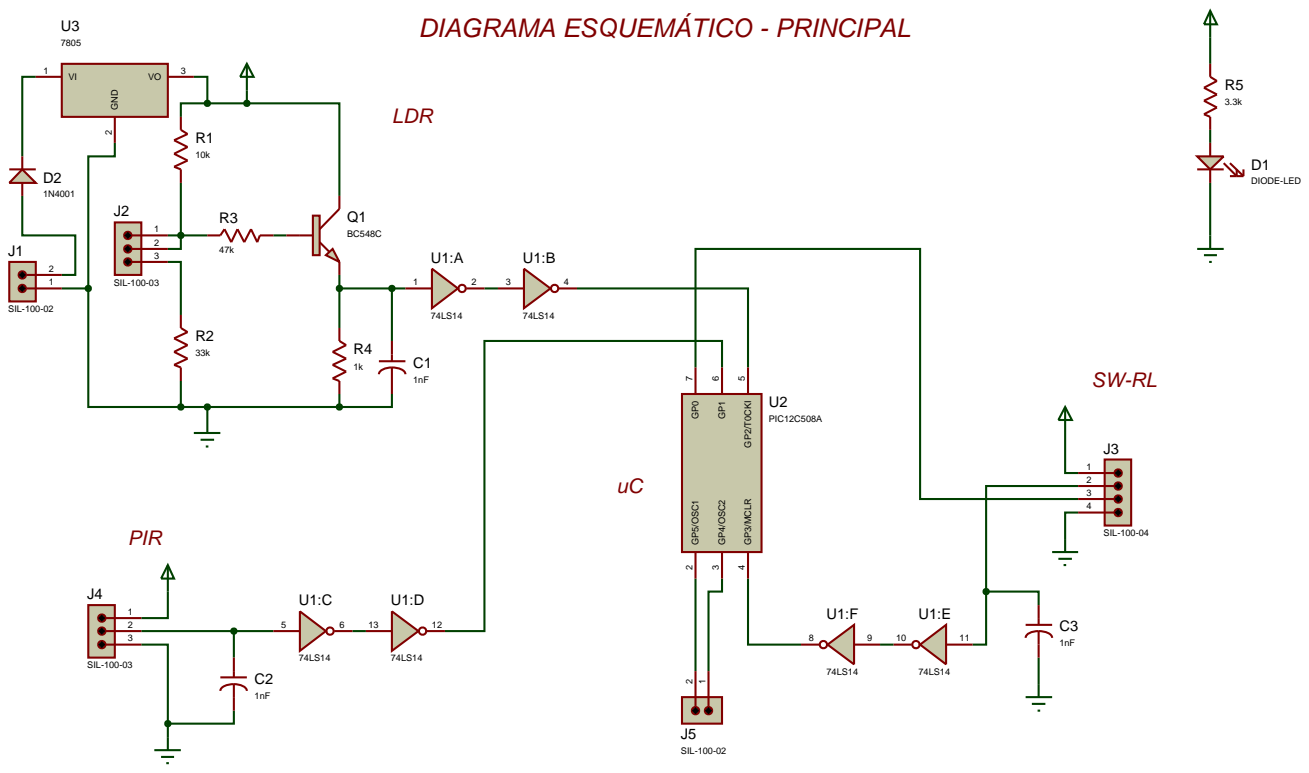
[picture p98: page 1]
