jalmx/Smart-Switch/PCB/MAIN_PCB/MAINt_pcb.pdf

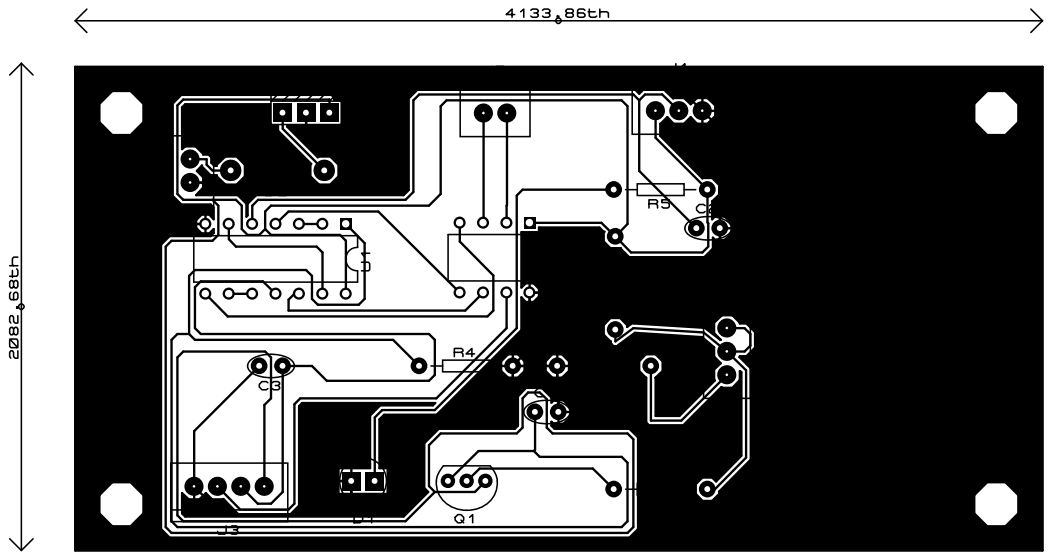
[picture p99: page 1]
