jalmx/Smart-Switch/General/SW_SCHEMATIC.pdf

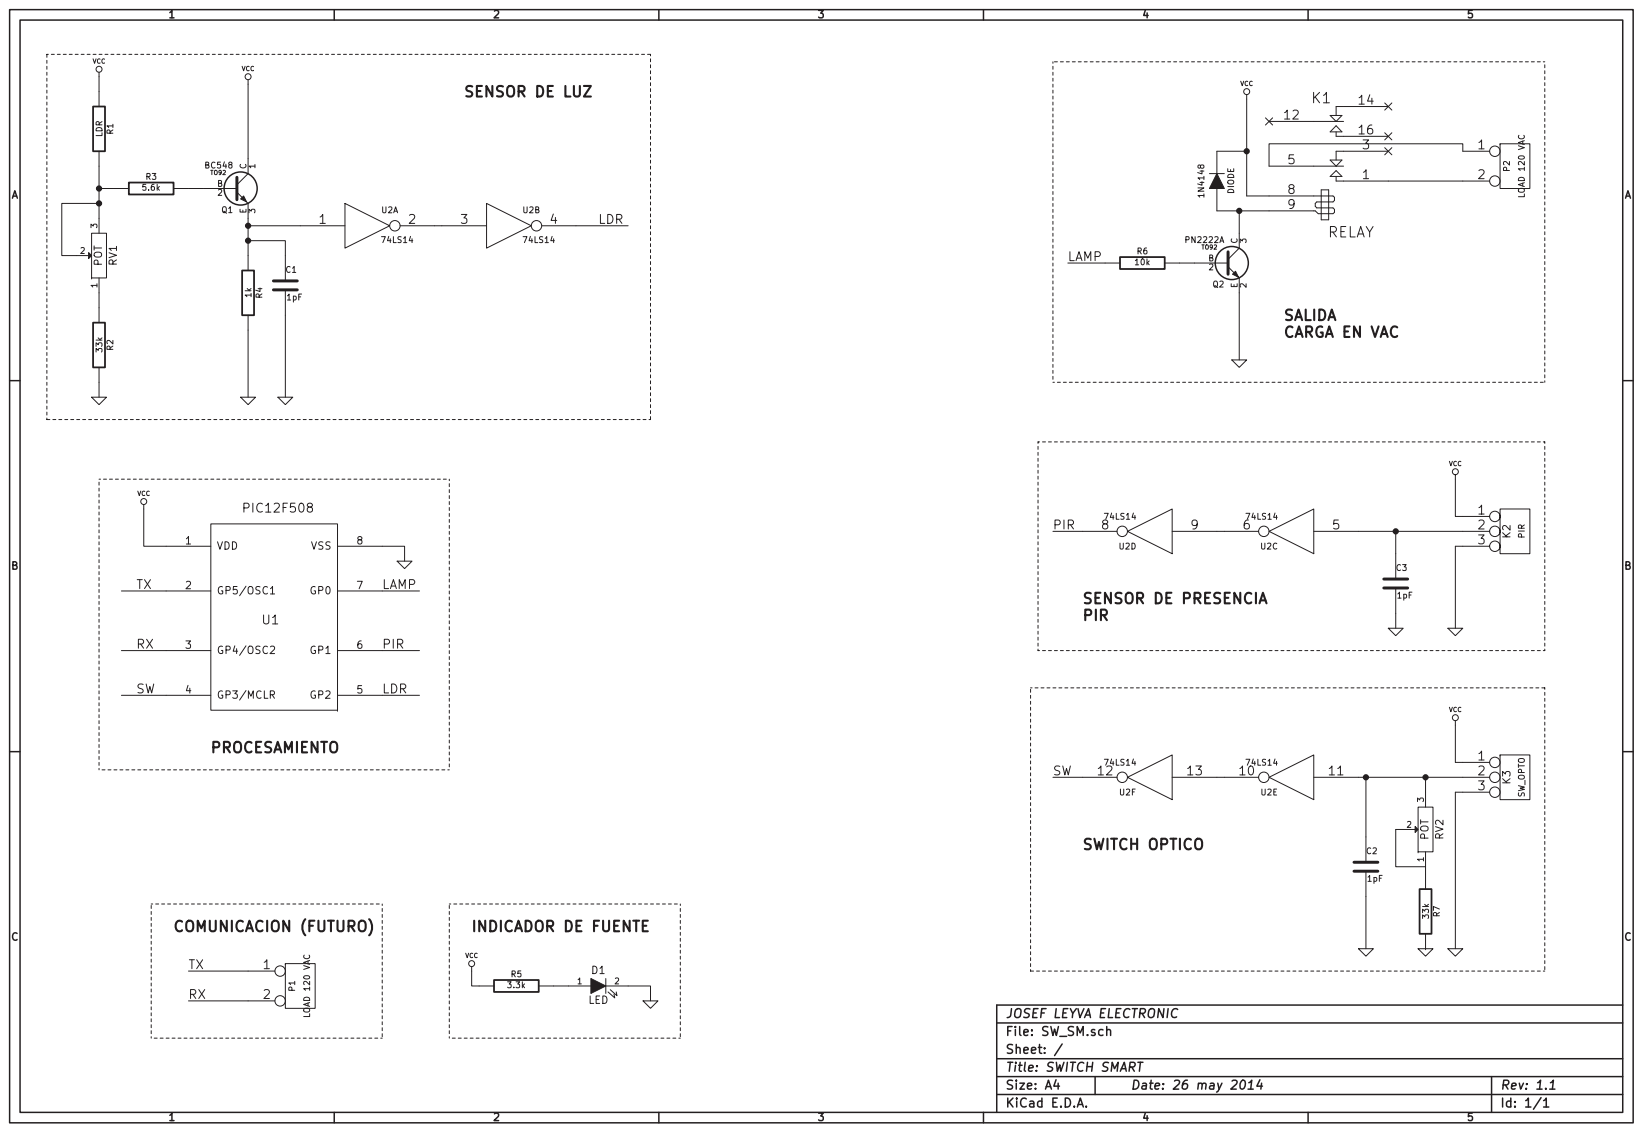
[picture p100: page 1]

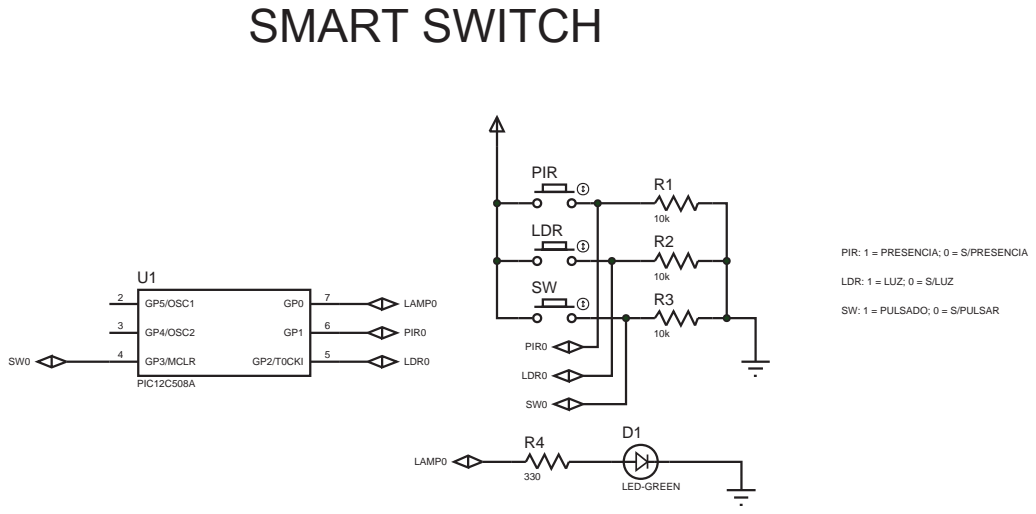
[picture p101: page 2]

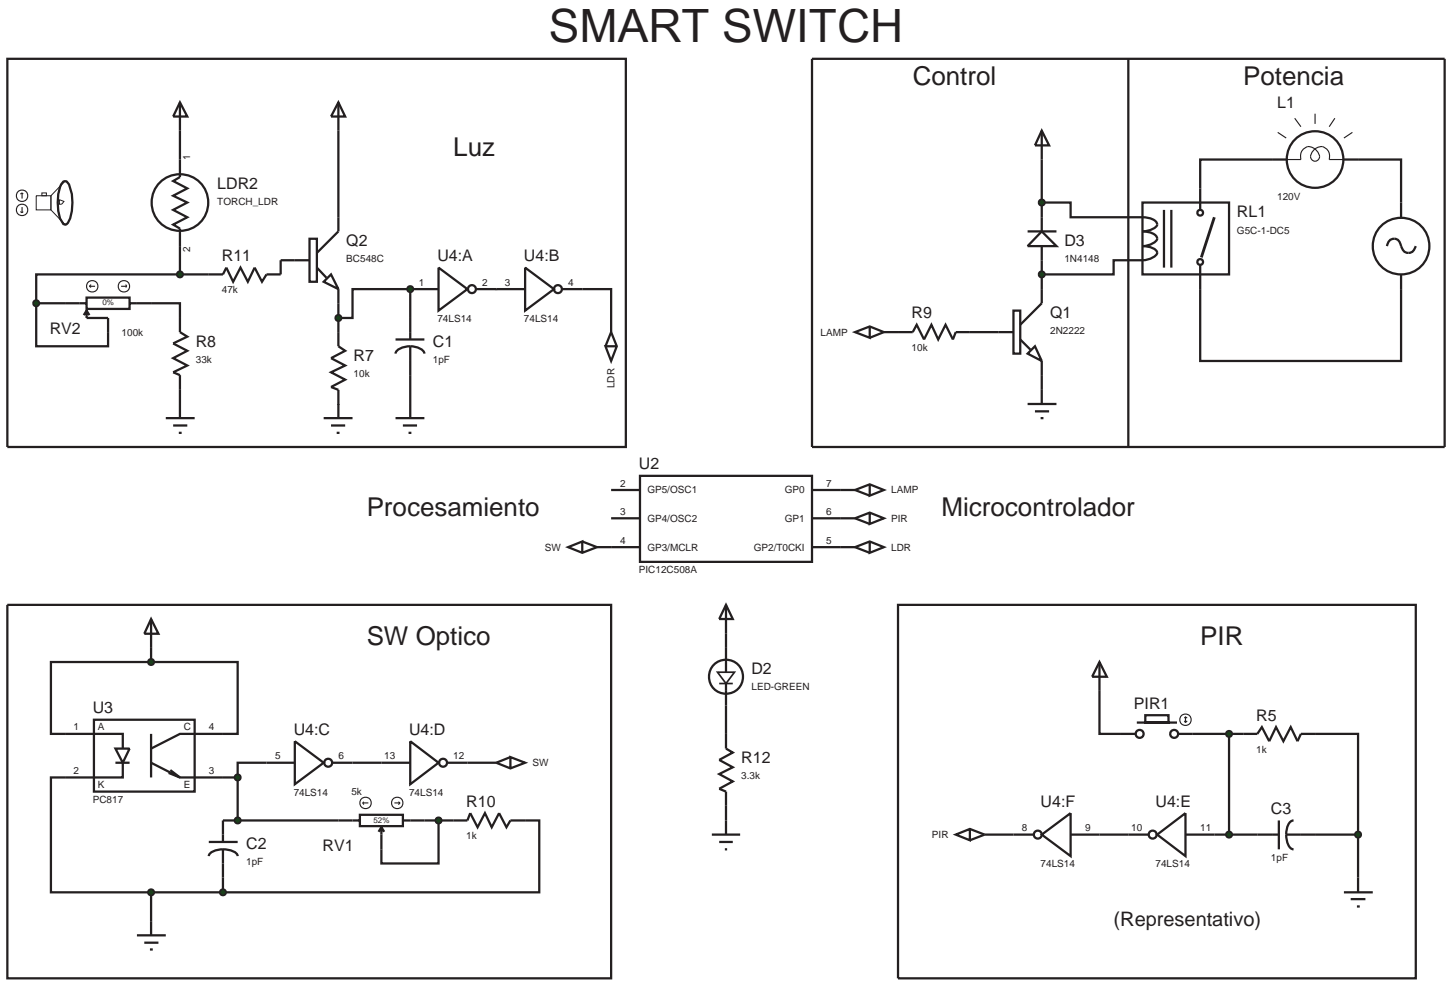
[picture p102: page 3]
