jalmx/Smart-Switch/PCB/MAIN_PCB/Main componentes TOP.pdf

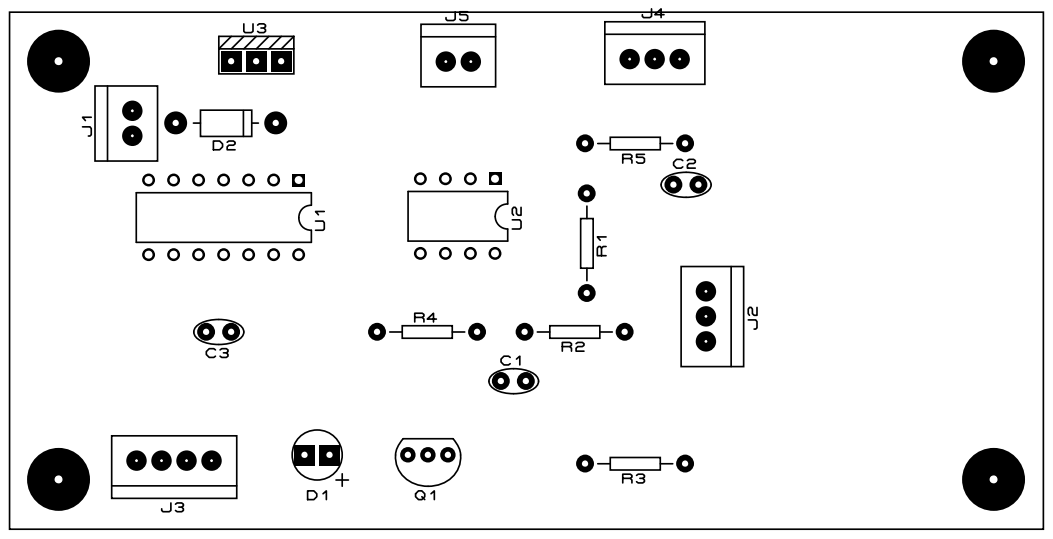
[picture p103: page 1]
