jalmx/Smart-Switch/PCB/MAIN_PCB/Main componentes TOP_2.pdf

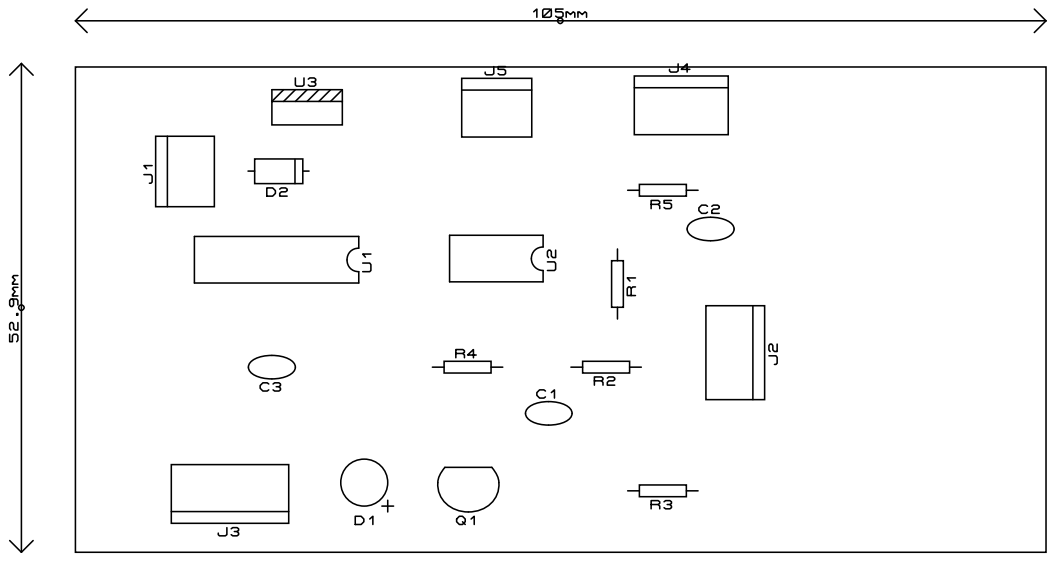
[picture p104: page 1]
