jalmx/Smart-Switch/Gabinete y Pictorico/Gabinete_2D.pdf

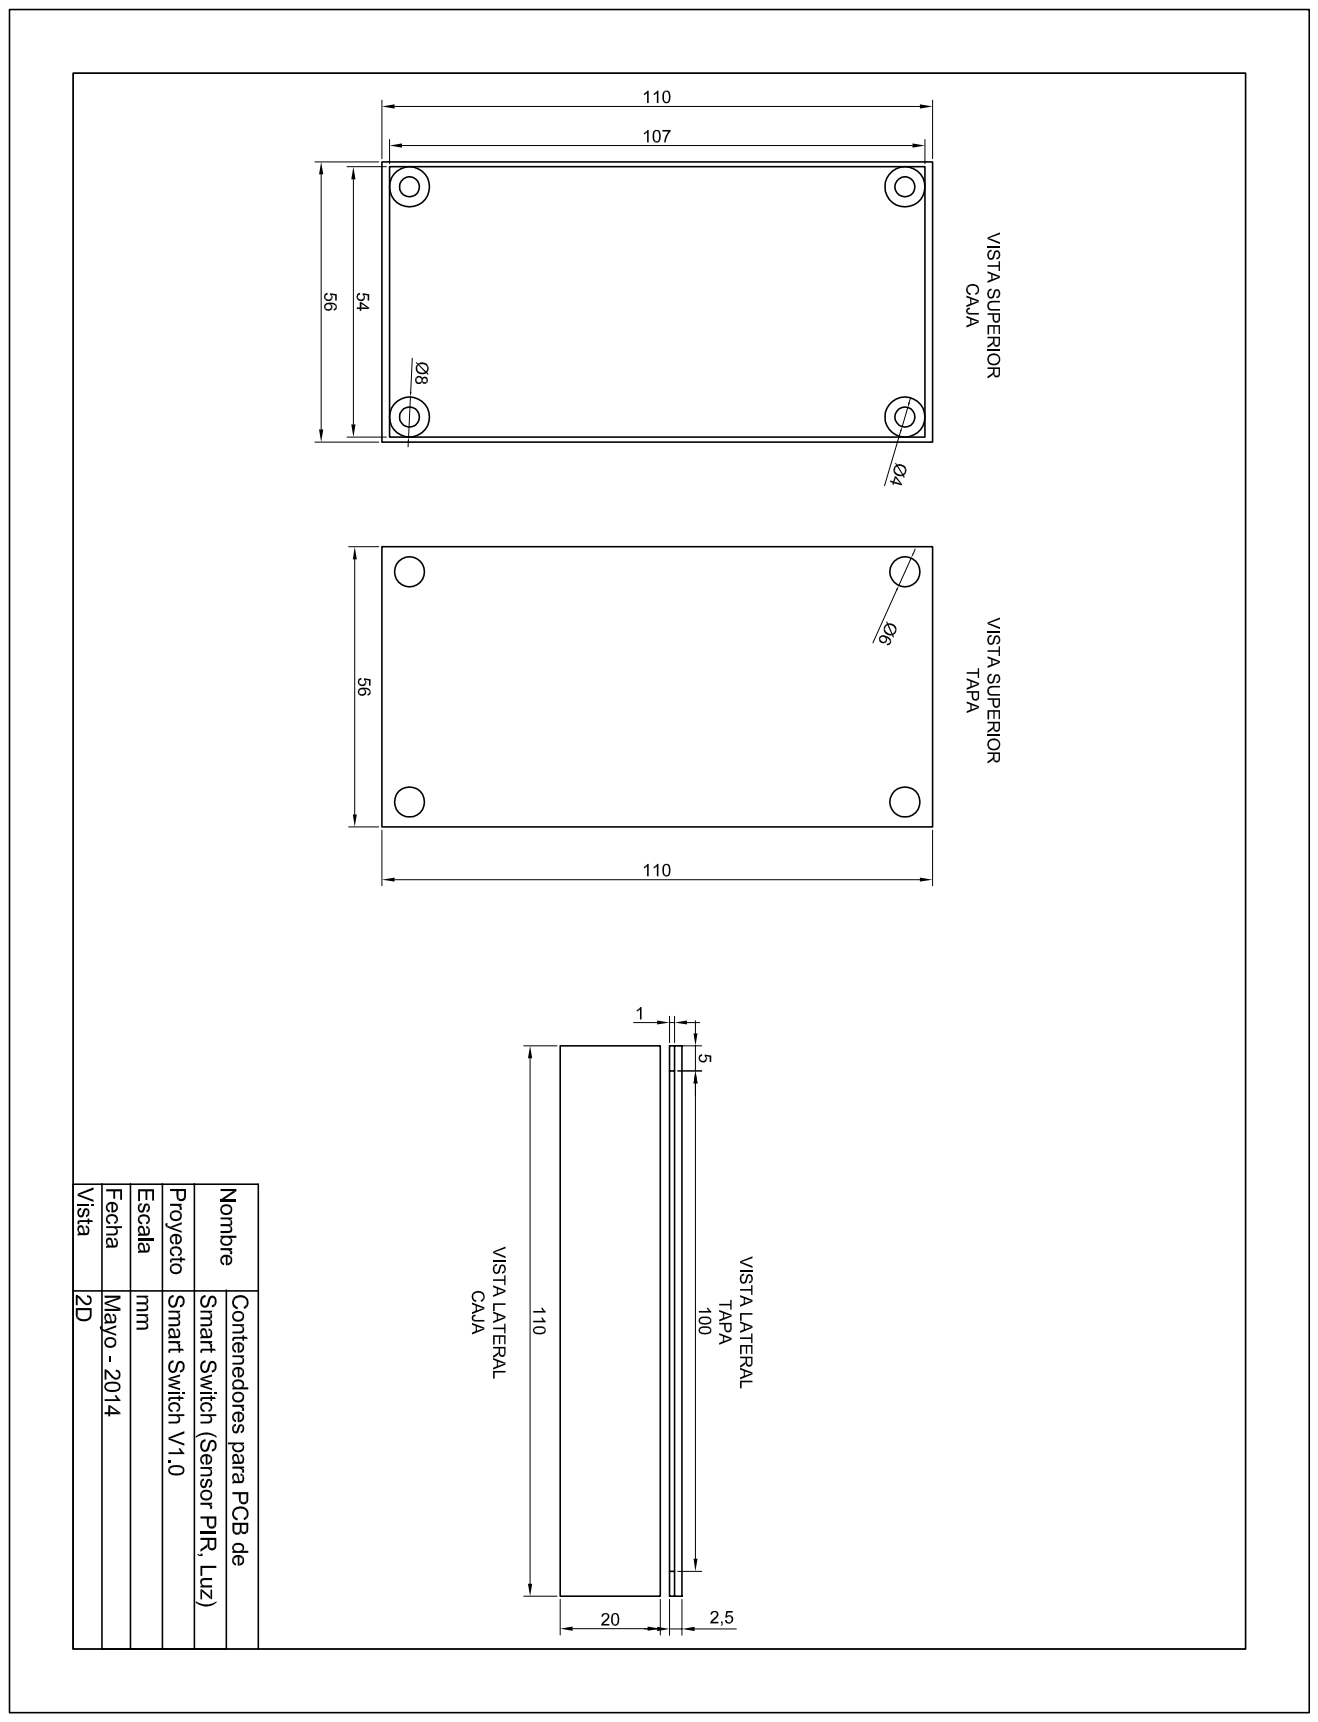
[picture p105: page 1]
