jalmx/Smart-Switch/Gabinete y Pictorico/Gabinete_Isom.pdf

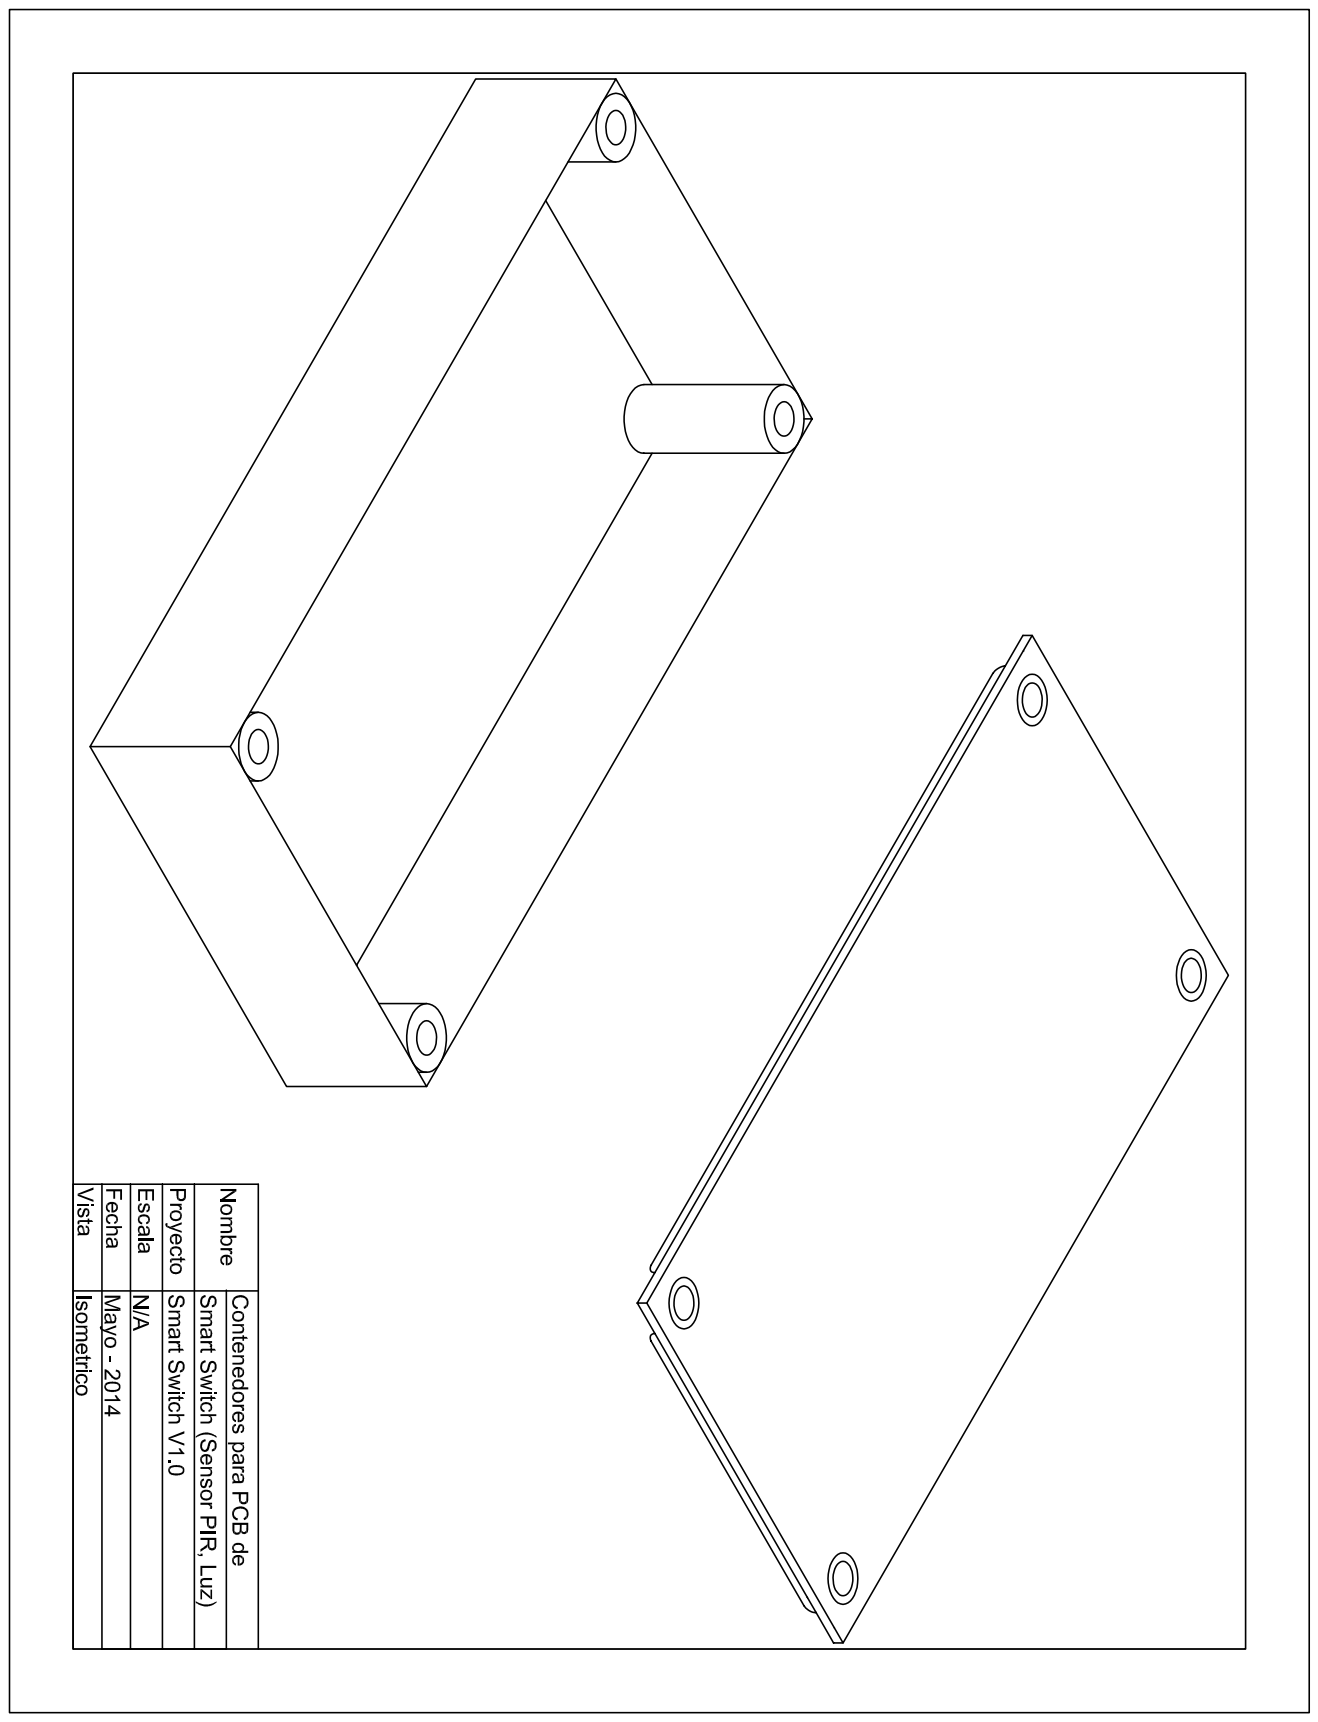
[picture p106: page 1]
