jalmx/Smart-Switch/PCB/PCB_all.pdf

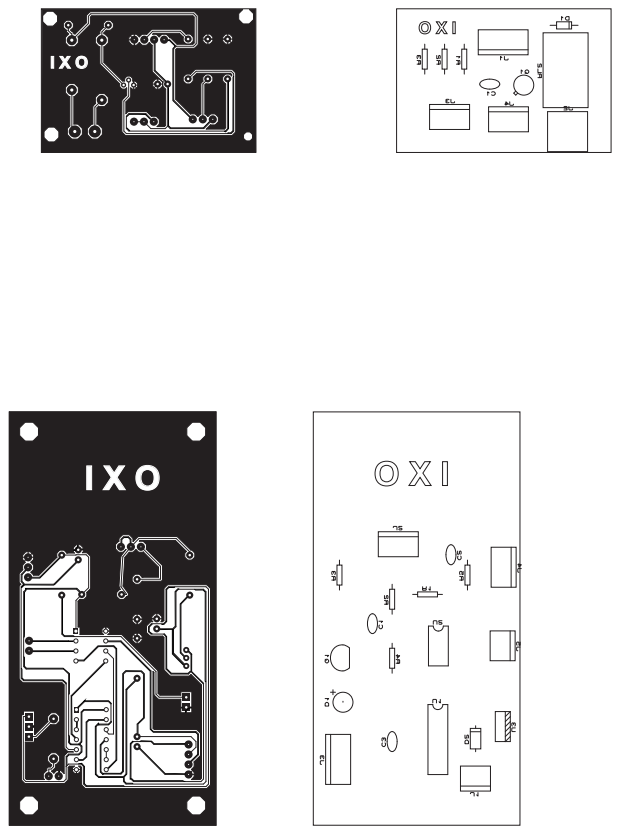
[picture p107: page 1]
