jalmx/Smart-Switch/PCB/MAIN_PCB/MAIN drill_perforacion.pdf

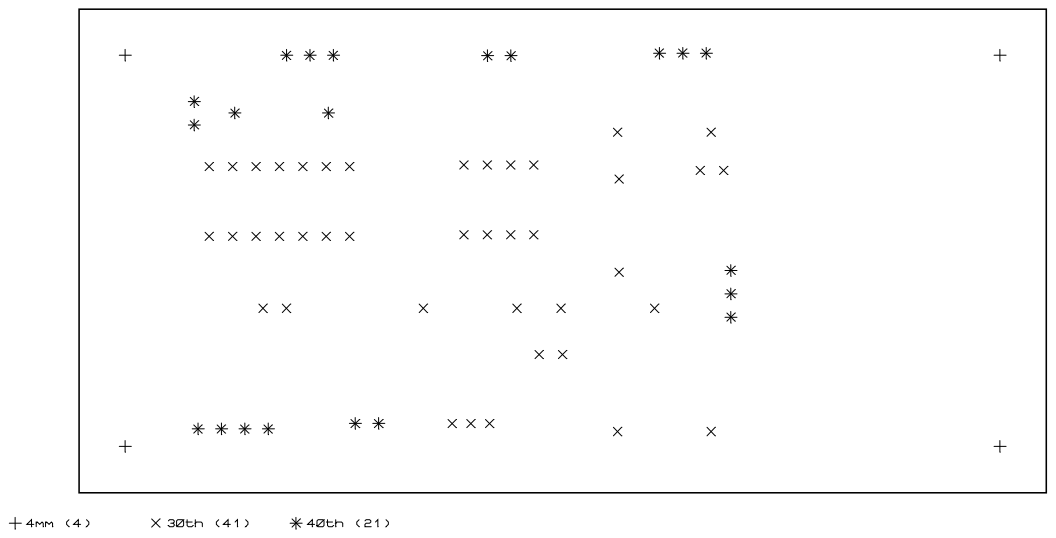
[picture p108: page 1]
