jalmx/Smart-Switch/PCB/MAIN_PCB/Main PCB.pdf

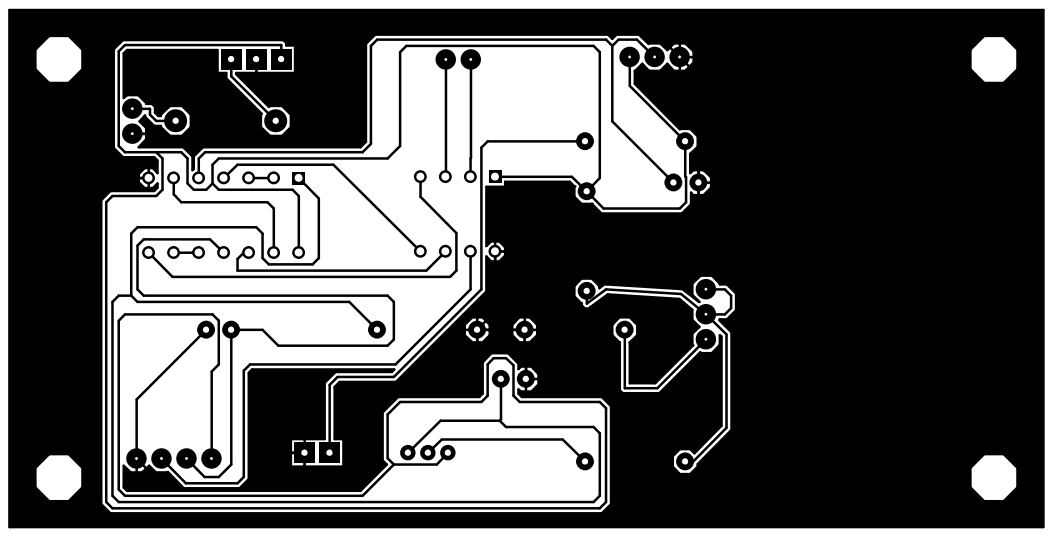
[picture p109: page 1]
