jalmx/Smart-Switch/PCB/SUB_PCB/SUB_cmp.pdf

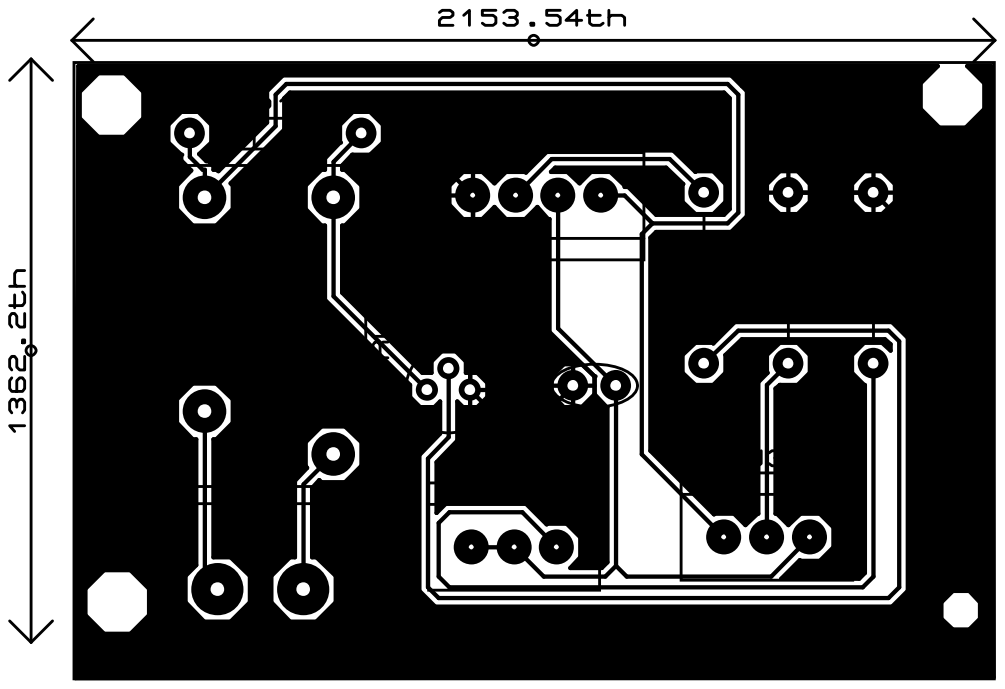
[picture p110: page 1]
