jalmx/Smart-Switch/PCB/SUB_PCB/SUB_drill_perforaciones.pdf

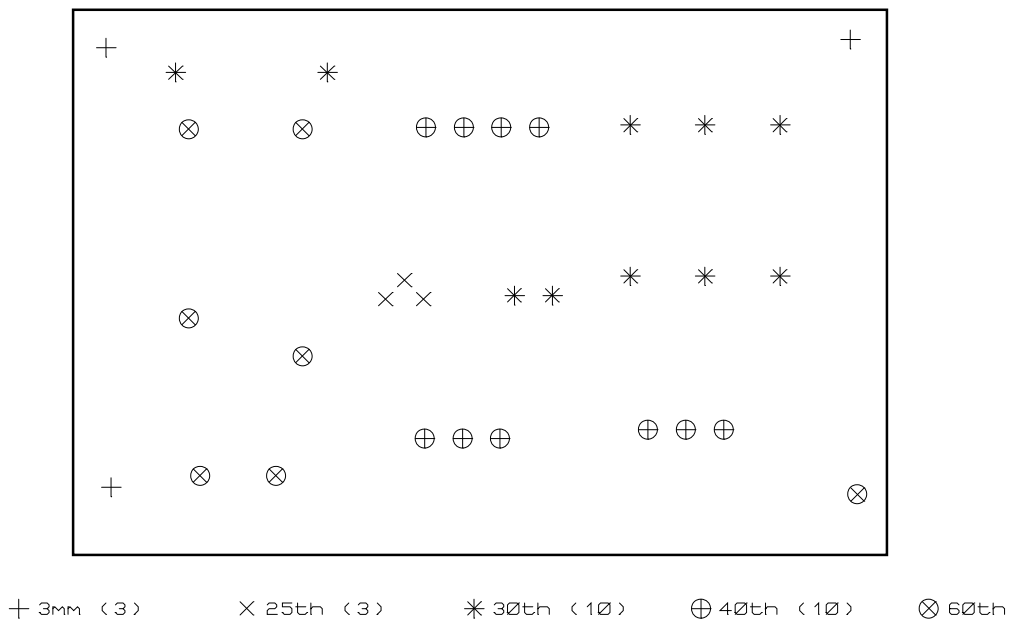
[picture p111: page 1]
