jalmx/Smart-Switch/PCB/SUB_PCB/SUB_general.pdf

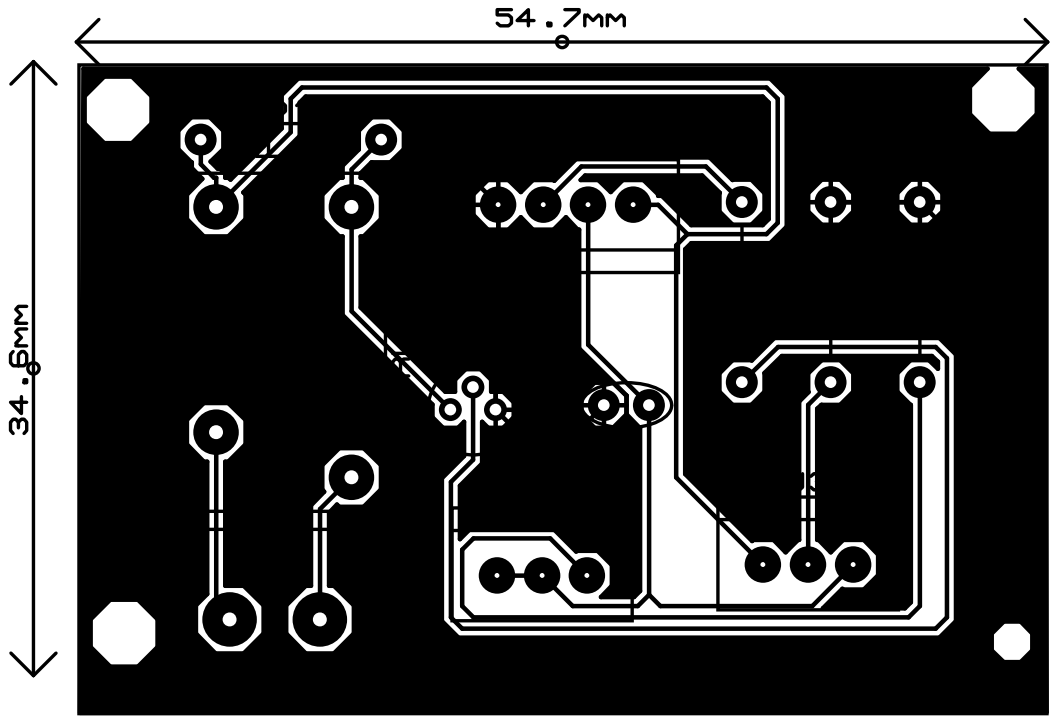
[picture p112: page 1]
