jalmx/Smart-Switch/PCB/SUB_PCB/SUB_PCB.pdf

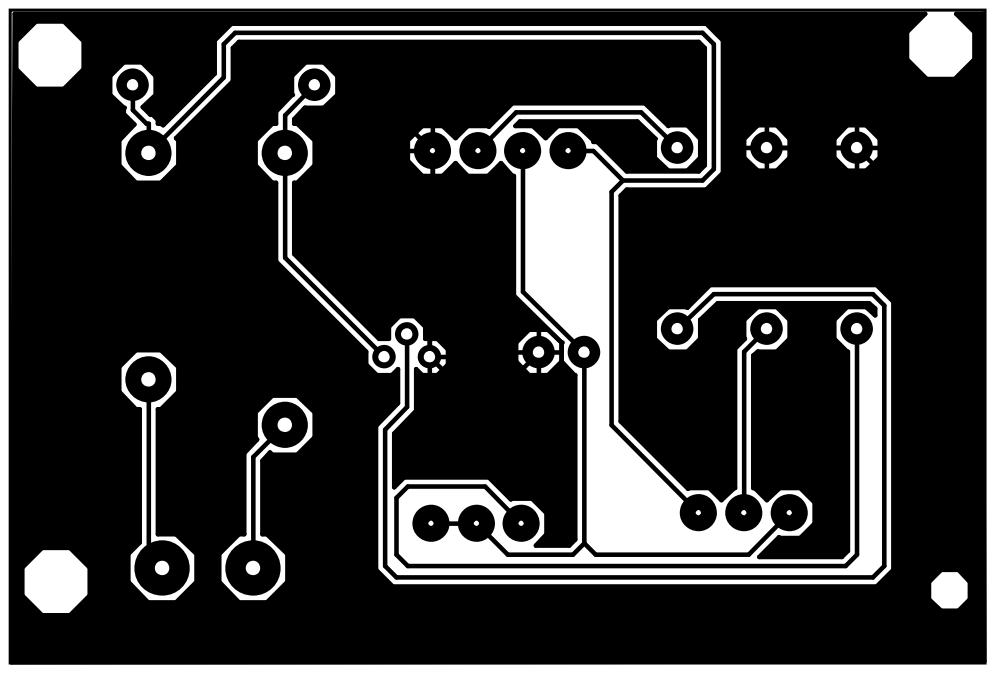
[picture p113: page 1]
