jalmx/Smart-Switch/PCB/SW_OP_PCB/sw_op.pdf

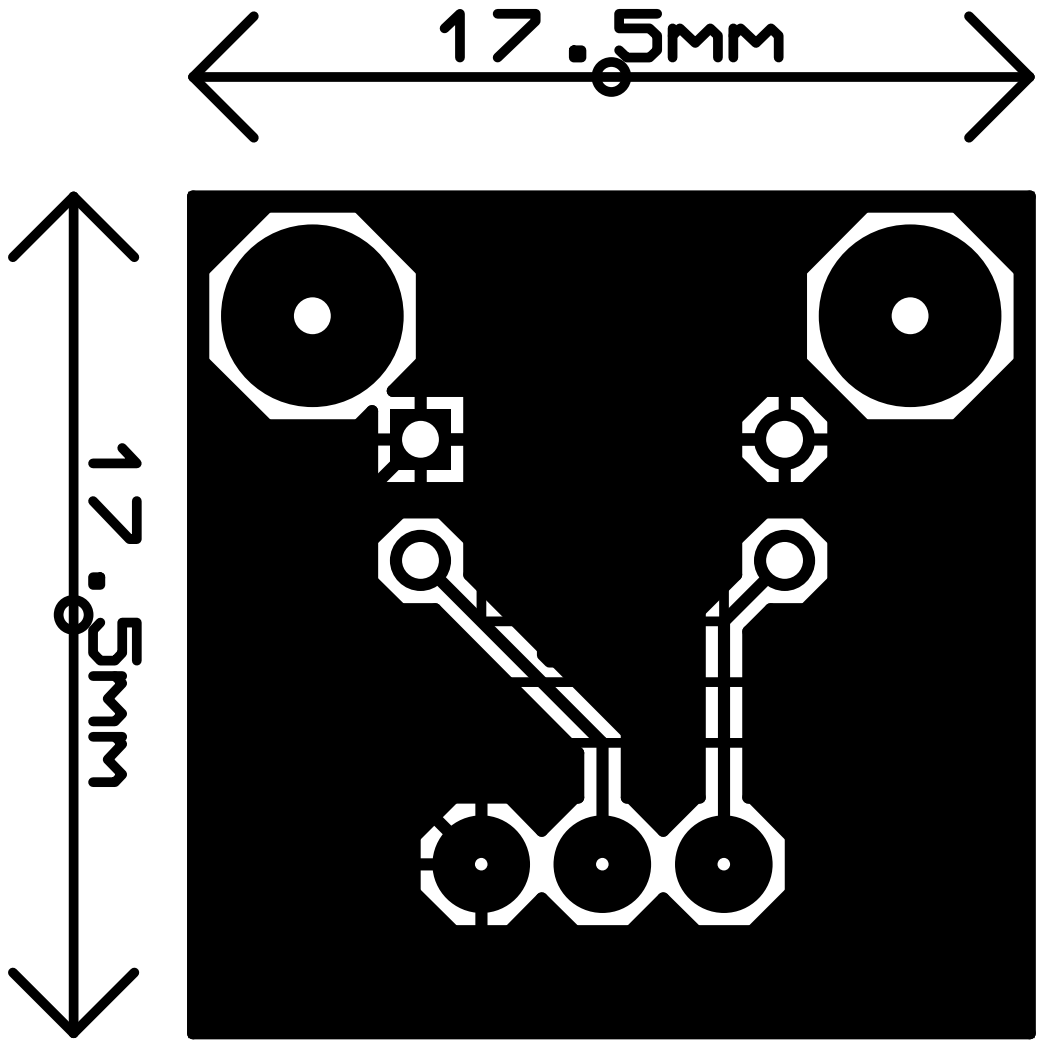
[picture p114: page 1]
