jalmx/Smart-Switch/(list of files, drawings)

Other design files:
PCB/MAINt.pdsprj
PCB/SUB.pdsprj
PCB/sw_op.pdsprj
SW_SMART.X/SW-SMART.pdsprj
